ocxpke/ocx/carcasa/img/pieza_07_pisapantalla_der.png

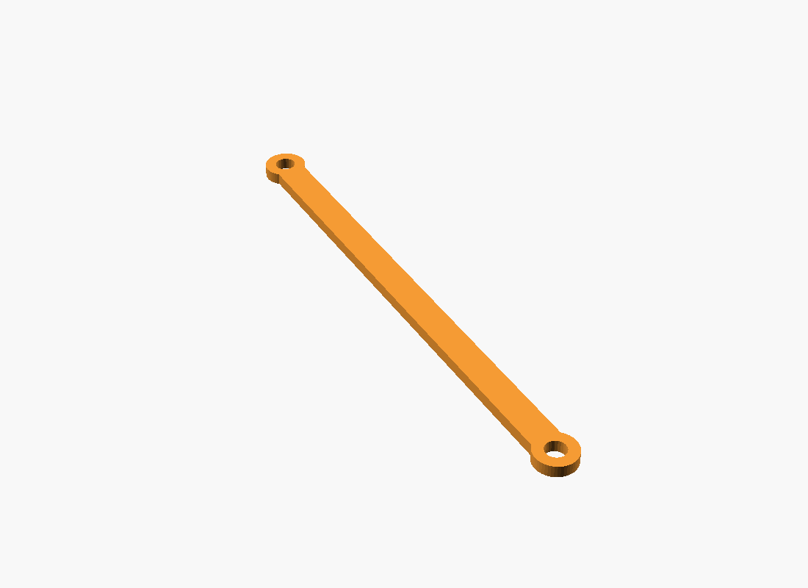
carcasa/img/pieza_07_pisapantalla_der.png
