ocxpke/ocx/carcasa/stl/02_frontal_central.stl

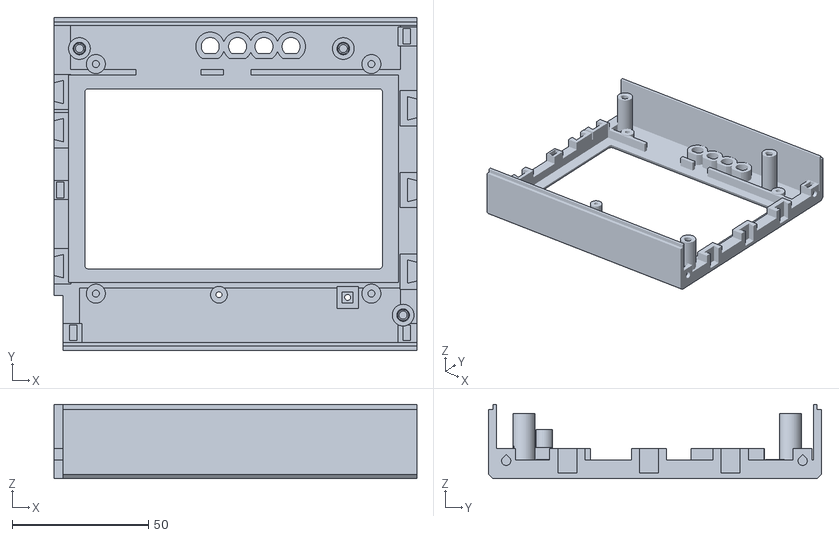
[picture p3: CAD file, 2026-11-05]
carcasa/stl/02_frontal_central.stl
133.4 x 122.4 x 27.2
