ocxpke/ocx/carcasa/stl/capuchones/capuchon_SW9_home.stl

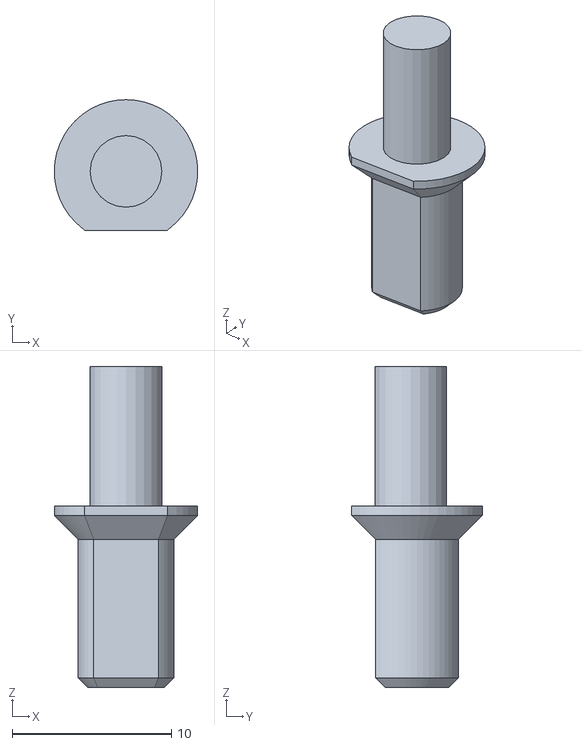
[picture p4: CAD file, 2026-11-05]
carcasa/stl/capuchones/capuchon_SW9_home.stl
9.01 x 8.20 x 20.1
