ocxpke/ocx/carcasa/stl/07_pisapantalla_der.stl

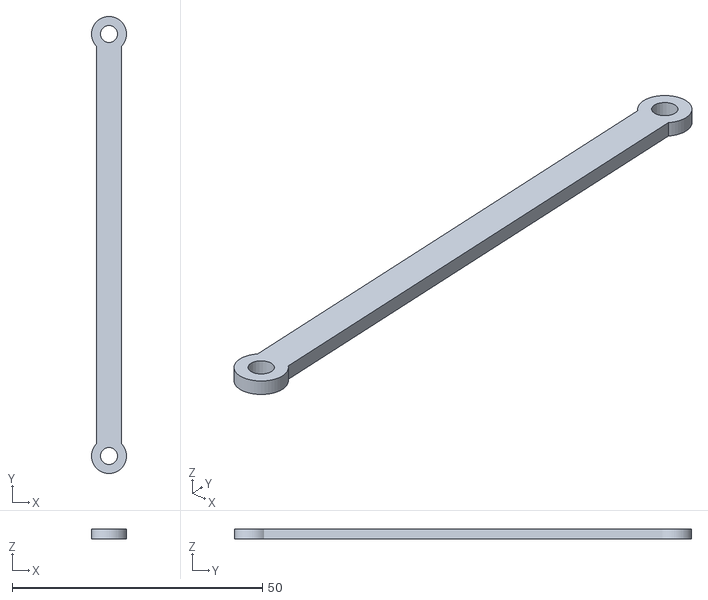
[picture p5: CAD file, 2026-11-05]
carcasa/stl/07_pisapantalla_der.stl
7.00 x 91.4 x 2.00
