ocxpke/ocx/carcasa/stl/00_probeta_ajustes.stl

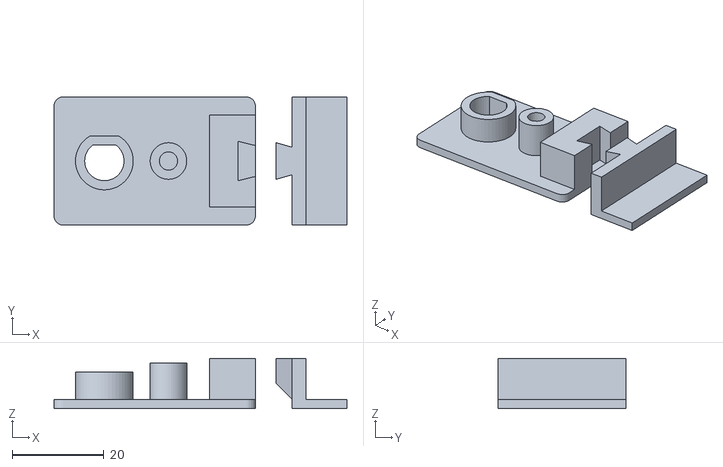
[picture p6: CAD file, 2026-11-05]
carcasa/stl/00_probeta_ajustes.stl
64.0 x 28.0 x 11.0
