ocxpke/ocx/carcasa/stl/capuchones/capuchon_SW13_T_triangulo.stl

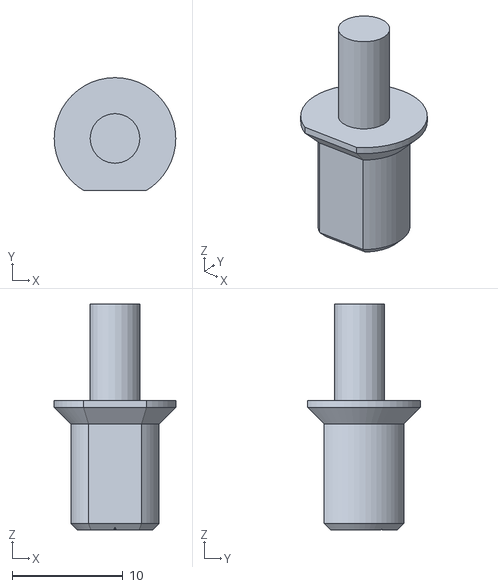
[picture p7: CAD file, 2026-11-05]
carcasa/stl/capuchones/capuchon_SW13_T_triangulo.stl
11.0 x 10.2 x 20.4
