ocxpke/ocx/carcasa/stl/09_bandeja_capuchones.stl

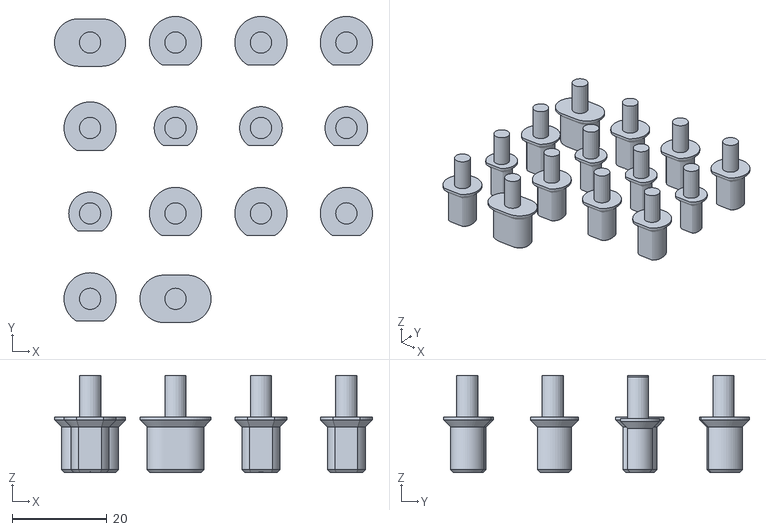
[picture p8: CAD file, 2026-11-05]
carcasa/stl/09_bandeja_capuchones.stl
67.0 x 64.5 x 20.4
