ocxpke/ocx/carcasa/stl/capuchones/capuchon_SW15_gatillo_R.stl

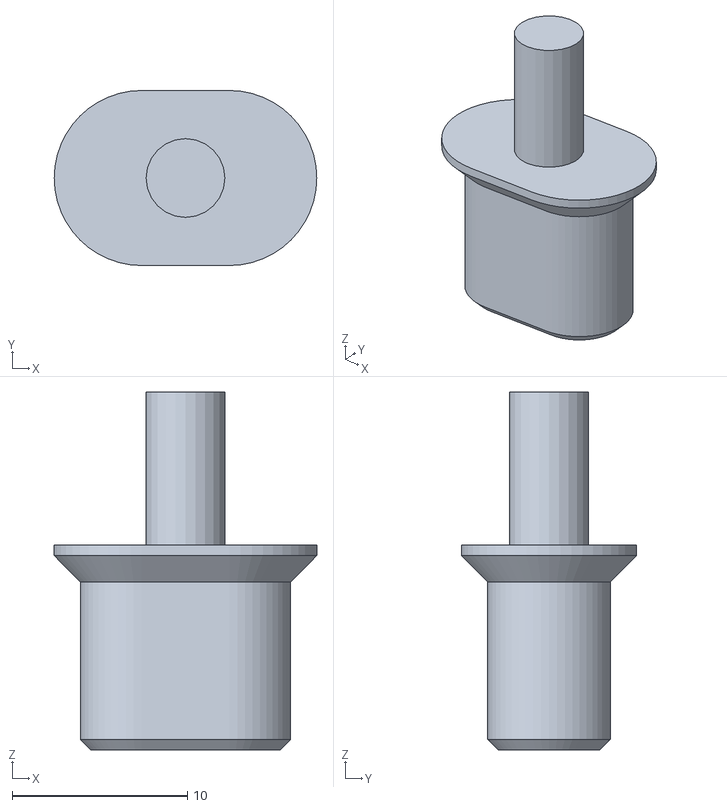
[picture p9: CAD file, 2026-11-05]
carcasa/stl/capuchones/capuchon_SW15_gatillo_R.stl
15.0 x 10.0 x 20.4
