ocxpke/ocx/carcasa/stl/05_trasera_derecha.stl

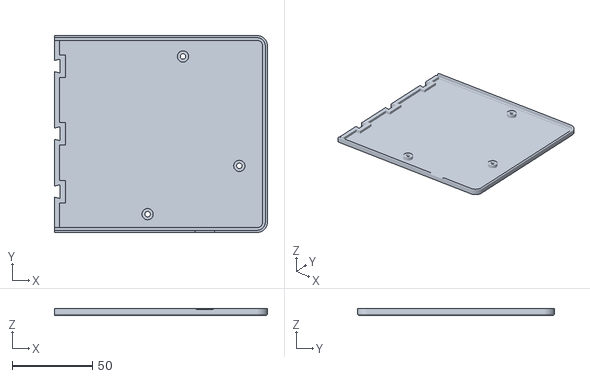
[picture p10: CAD file, 2026-11-05]
carcasa/stl/05_trasera_derecha.stl
132.4 x 122.4 x 4.50
