ocxpke/ocx/carcasa/stl/04_trasera_izquierda.stl

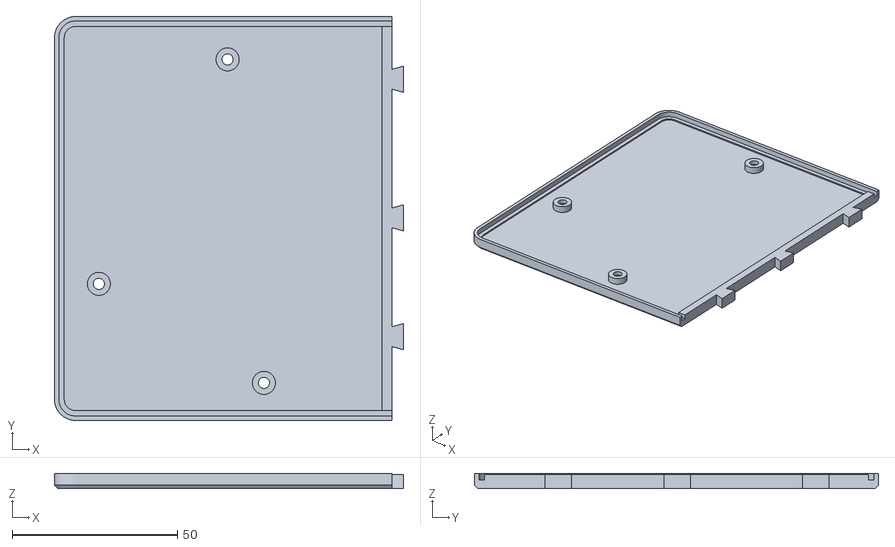
[picture p11: CAD file, 2026-11-05]
carcasa/stl/04_trasera_izquierda.stl
105.8 x 122.4 x 4.50
