ocxpke/ocx/carcasa/stl/03_frontal_derecha.stl

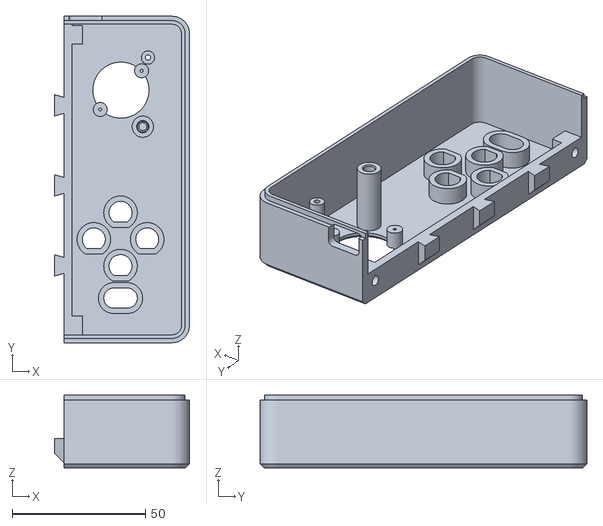
[picture p12: CAD file, 2026-11-05]
carcasa/stl/03_frontal_derecha.stl
50.6 x 122.4 x 27.2
