ocxpke/ocx/carcasa/stl/01_frontal_izquierda.stl

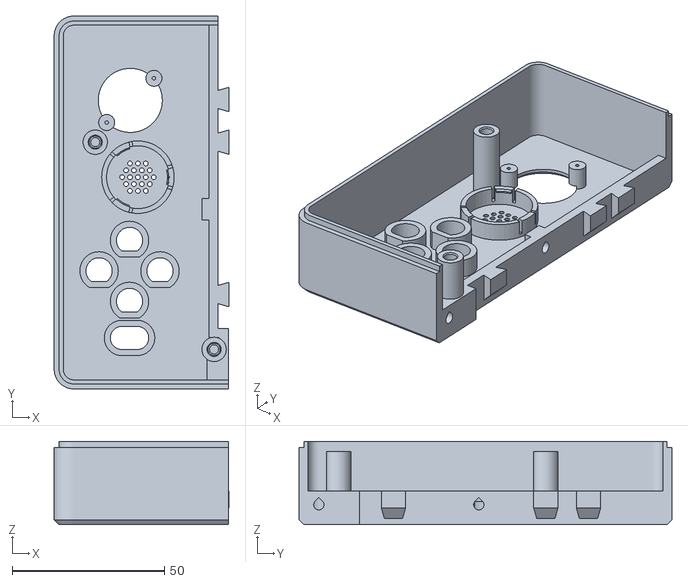
[picture p13: CAD file, 2026-11-05]
carcasa/stl/01_frontal_izquierda.stl
57.3 x 122.4 x 27.2
