ocxpke/ocx/carcasa/stl/capuchones/capuchon_SW7_vol_menos.stl

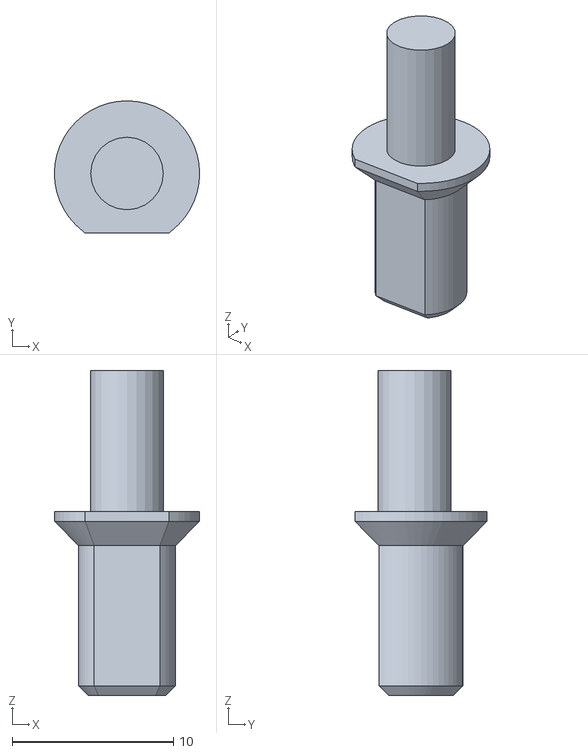
[picture p14: CAD file, 2026-11-05]
carcasa/stl/capuchones/capuchon_SW7_vol_menos.stl
9.01 x 8.20 x 20.1
