ocxpke/ocx/carcasa/stl/08_empujador_boot.stl

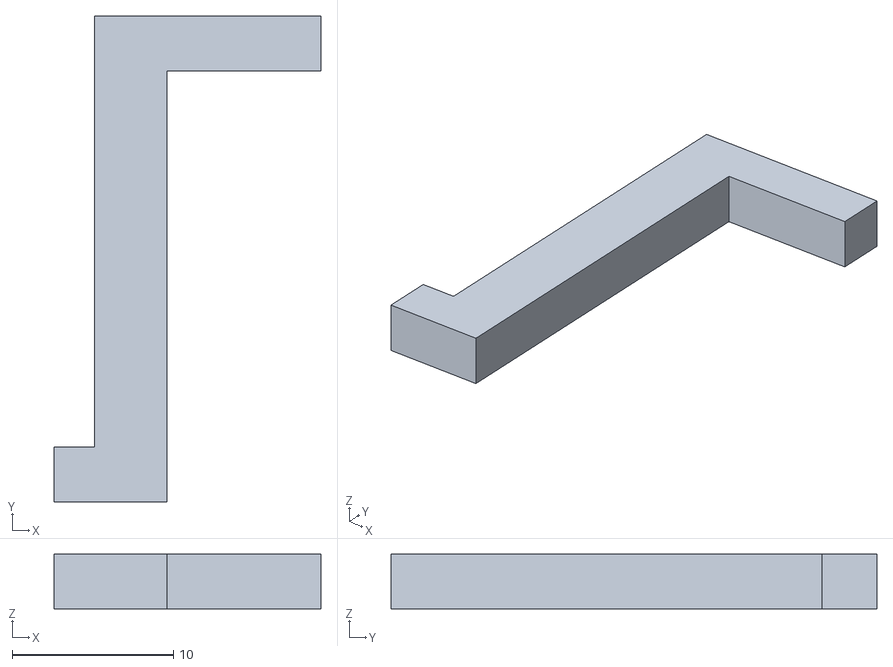
[picture p15: CAD file, 2026-11-05]
carcasa/stl/08_empujador_boot.stl
16.5 x 30.1 x 3.40
