ocxpke/ocx/carcasa/stl/capuchones/capuchon_SW4_izquierda.stl

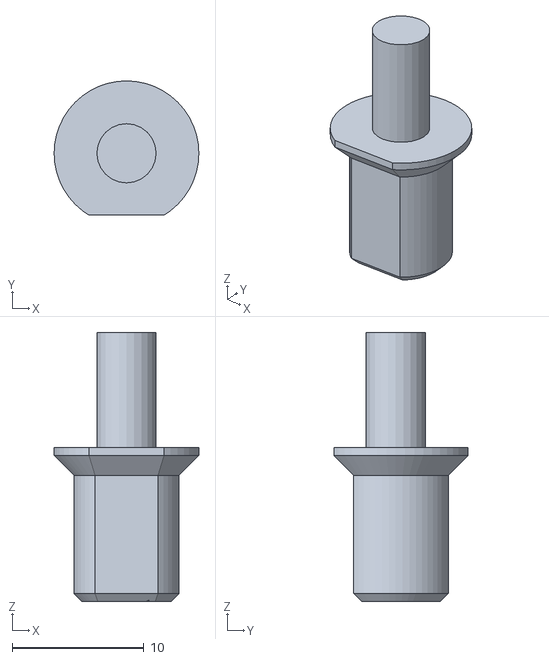
[picture p16: CAD file, 2026-11-05]
carcasa/stl/capuchones/capuchon_SW4_izquierda.stl
11.0 x 10.2 x 20.4
