ocxpke/ocx/carcasa/scad/pcb_data.scad

// GENERADO por carcasa/scripts/extraer_pcb.py a partir de hardware/ocxPrototype.kicad_pcb
// No lo edites a mano: vuelve a ejecutar el script si cambia la placa.
// Coordenadas del .kicad_pcb (mm, eje Y hacia abajo).

PCB_GROSOR = 1.6;
PCB_BBOX = [16, 14.5, 244, 129.9003];   // [xmin, ymin, xmax, ymax]
PCB_ANCHO = 228;
PCB_ALTO = 115.4003;
PCB_RADIO_ESQUINA = 3;
PCB_MUESCA_ANTENA = [136, 14.5, 176, 22.3];   // [xmin, ymin, xmax, ymax]
PCB_CONTORNO = [[16, 17.5], [16, 126.9003], [16.0189, 127.2362], [16.0752, 127.5679], [16.1684, 127.8912], [16.2971, 128.202], [16.4598, 128.4964], [16.6545, 128.7708], [16.8787, 129.0216], [17.1295, 129.2458], [17.4039, 129.4405], [17.6983, 129.6032], [18.0092, 129.732], [18.3324, 129.8251], [18.6641, 129.8815], [19, 129.9003], [241, 129.9003], [241.3359, 129.8815], [241.6676, 129.8251], [241.9908, 129.732], [242.3017, 129.6032], [242.5961, 129.4405], [242.8705, 129.2458], [243.1213, 129.0216], [243.3455, 128.7708], [243.5402, 128.4964], [243.7029, 128.202], [243.8316, 127.8912], [243.9248, 127.5679], [243.9811, 127.2362], [244, 126.9003], [244, 17.5], [243.9836, 17.1865], [243.9344, 16.8763], [243.8532, 16.573], [243.7406, 16.2798], [243.5981, 16], [243.427, 15.7367], [243.2294, 15.4926], [243.0074, 15.2706], [242.7633, 15.073], [242.5, 14.902], [242.2202, 14.7594], [241.927, 14.6469], [241.6237, 14.5656], [241.3135, 14.5165], [241, 14.5], [176, 14.5], [176, 22.3], [136, 22.3], [136, 14.5], [19, 14.5], [18.6641, 14.5189], [18.3324, 14.5752], [18.0092, 14.6684], [17.6983, 14.7971], [17.4039, 14.9598], [17.1295, 15.1545], [16.8787, 15.3787], [16.6545, 15.6295], [16.4598, 15.9039], [16.2971, 16.1983], [16.1684, 16.5092], [16.0752, 16.8324], [16.0189, 17.1641]];
// Agujeros de montaje: [x, y, diámetro]
PCB_AGUJEROS = [[195, 24, 3.2], [230, 92, 3.2], [26, 92, 3.2], [65, 24, 3.2], [173, 122, 3.2], [76, 122, 3.2]];
// Componentes: [ref, valor, huella, x, y, giro, courtyard[x0,y0,x1,y1], fab[x0,y0,x1,y1], centro_pads[x,y], altura, grupo]
PCB_COMPONENTES = [
  ["U6", "LMR51430", "SOT-23-6", 192.58, 107.05, 90, [190.88, 105, 194.28, 109.1], [191.13, 106.25, 194.03, 107.85], [192.58, 107.05], 1.45, "smd"],
  ["R11", "10k", "R_0805_2012Metric_Pad1.20x1.40mm_HandSolder", 129.5, 55.8, 90, [128.55, 53.95, 130.45, 57.65], [128.875, 54.8, 130.125, 56.8], [129.5, 55.8], 1.3, "smd"],
  ["R17", "10k", "R_0805_2012Metric_Pad1.20x1.40mm_HandSolder", 140.9, 34.3, 0, [139.05, 33.35, 142.75, 35.25], [139.9, 33.675, 141.9, 34.925], [140.9, 34.3], 1.3, "smd"],
  ["C36", "100nF", "C_0805_2012Metric_Pad1.18x1.45mm_HandSolder", 130.1, 95.8, 0, [128.22, 94.82, 131.98, 96.78], [129.1, 95.175, 131.1, 96.425], [130.1, 95.8], 1.3, "smd"],
  ["R9", "100 Ohms", "R_0805_2012Metric_Pad1.20x1.40mm_HandSolder", 226.925, 117.9, 180, [225.075, 116.95, 228.775, 118.85], [225.925, 117.275, 227.925, 118.525], [226.925, 117.9], 1.3, "smd"],
  ["U7", "W25Q128JVS", "SOIC-8_5.3x5.3mm_P1.27mm", 135.5, 56.5, 0, [130.85, 53.6, 140.15, 59.4], [132.85, 53.85, 138.15, 59.15], [135.5, 56.5], 2.2, "smd"],
  ["C18", "220pF C0G", "C_0805_2012Metric_Pad1.18x1.45mm_HandSolder", 56.4888, 105.719, 90, [55.509, 103.839, 57.469, 107.599], [55.864, 104.719, 57.114, 106.719], [56.489, 105.719], 1.3, "smd"],
  ["U2", "USBLC6-2SC6", "SOT-23-6", 207.98, 113.05, -90, [206.28, 111, 209.68, 115.1], [206.53, 112.25, 209.43, 113.85], [207.98, 113.05], 1.45, "smd"],
  ["C20", "10uF 25V", "C_0805_2012Metric_Pad1.18x1.45mm_HandSolder", 82.1375, 83.7, 180, [80.258, 82.72, 84.017, 84.68], [81.138, 83.075, 83.138, 84.325], [82.137, 83.7], 1.3, "smd"],
  ["FB2", "100 Ohms @ 100 MHz 0.8A", "L_0805_2012Metric_Pad1.05x1.20mm_HandSolder", 53.1888, 106.7565, 0, [51.259, 105.906, 55.119, 107.606], [52.189, 106.306, 54.189, 107.206], [53.189, 106.756], 1.3, "smd"],
  ["C21", "2.2uF 50V", "C_1206_3216Metric_Pad1.33x1.80mm_HandSolder", 93.3375, 82.6, 180, [90.858, 81.45, 95.818, 83.75], [91.738, 81.8, 94.938, 83.4], [93.338, 82.6], 1.8, "smd"],
  ["R10", "47k", "R_0805_2012Metric_Pad1.20x1.40mm_HandSolder", 46.8888, 106.0565, 0, [45.039, 105.106, 48.739, 107.006], [45.889, 105.431, 47.889, 106.681], [46.889, 106.056], 1.3, "smd"],
  ["SW14", "SW_Reset", "SW_PUSH_6mm", 130.55, 33.75, 180, [122.55, 27.75, 132.05, 35.25], [124.3, 28.5, 130.3, 34.5], [127.3, 31.5], 5, "pulsador"],
  ["J7", "JoystickRight", "TE_0-1734839-5_1x05-1MP_P0.5mm_Horizontal", 221.8, 80, 0, [217.33, 77.59, 226.27, 84.25], [217.835, 79.35, 225.765, 83.75], [221.8, 78.65], 2, "conector"],
  ["SW10", "BTN_X", "SW_PUSH_6mm", 224.9, 62, 180, [216.9, 56, 226.4, 63.5], [218.65, 56.75, 224.65, 62.75], [221.65, 59.75], 5, "pulsador"],
  ["TP3", "TestPoint", "TestPoint_Pad_D1.5mm", 184.5, 124.2, 180, [183.25, 122.95, 185.75, 125.45], undef, [184.5, 124.2], 0.2, "smd"],
  ["C15", "10uF 25V", "C_0805_2012Metric_Pad1.18x1.45mm_HandSolder", 197.18, 109.95, 0, [195.3, 108.97, 199.06, 110.93], [196.18, 109.325, 198.18, 110.575], [197.18, 109.95], 1.3, "smd"],
  ["C3", "1uF", "C_0402_1005Metric", 127.4, 67.3, 90, [126.94, 66.39, 127.86, 68.21], [127.15, 66.8, 127.65, 67.8], [127.4, 67.3], 0.7, "smd"],
  ["C2", "33pF C0G", "C_0402_1005Metric", 121.5975, 48.555, 0, [120.688, 48.095, 122.507, 49.015], [121.097, 48.305, 122.097, 48.805], [121.597, 48.555], 0.7, "smd"],
  ["C5", "100nF", "C_0402_1005Metric", 115.2, 52.58, -90, [114.74, 51.67, 115.66, 53.49], [114.95, 52.08, 115.45, 53.08], [115.2, 52.58], 0.7, "smd"],
  ["J6", "JoystickLeft", "TE_0-1734839-5_1x05-1MP_P0.5mm_Horizontal", 37.5, 80, 0, [33.03, 77.59, 41.97, 84.25], [33.535, 79.35, 41.465, 83.75], [37.5, 78.65], 2, "conector"],
  ["C28", "10uF 25V", "C_0805_2012Metric_Pad1.18x1.45mm_HandSolder", 117.7, 52.7, -90, [116.72, 50.82, 118.68, 54.58], [117.075, 51.7, 118.325, 53.7], [117.7, 52.7], 1.3, "smd"],
  ["SW5", "BTN_A_DW", "SW_PUSH_6mm", 40.5, 62, 180, [32.5, 56, 42, 63.5], [34.25, 56.75, 40.25, 62.75], [37.25, 59.75], 5, "pulsador"],
  ["R1", "1k", "R_0805_2012Metric_Pad1.20x1.40mm_HandSolder", 111, 58.3, 0, [109.15, 57.35, 112.85, 59.25], [110, 57.675, 112, 58.925], [111, 58.3], 1.3, "smd"],
  ["SW11", "BTN_O", "SW_PUSH_6mm", 234.9, 52, 180, [226.9, 46, 236.4, 53.5], [228.65, 46.75, 234.65, 52.75], [231.65, 49.75], 5, "pulsador"],
  ["L2", "22uH", "L_Sunlord_SWPA4030S", 85.5375, 87.4, 0, [83.237, 85.15, 87.837, 89.65], [83.537, 85.4, 87.537, 89.4], [85.537, 87.4], 3, "smd"],
  ["R14", "22 Ohms", "R_0805_2012Metric_Pad1.20x1.40mm_HandSolder", 171.8, 72.4, 180, [169.95, 71.45, 173.65, 73.35], [170.8, 71.775, 172.8, 73.025], [171.8, 72.4], 1.3, "smd"],
  ["C33", "100nF", "C_0805_2012Metric_Pad1.18x1.45mm_HandSolder", 170.6, 35.3375, -90, [169.62, 33.457, 171.58, 37.218], [169.975, 34.337, 171.225, 36.337], [170.6, 35.337], 1.3, "smd"],
  ["L3", "2.2uH", "L_Coilcraft_XxL4020", 192.68, 113.45, -90, [190.42, 111.19, 194.94, 115.71], [190.68, 111.45, 194.68, 115.45], [192.68, 113.45], 2.1, "smd"],
  ["SW9", "BTN_HOME", "SW_PUSH_6mm", 150.55, 120.5, 0, [149.05, 119, 158.55, 126.5], [150.8, 119.75, 156.8, 125.75], [153.8, 122.75], 5, "pulsador"],
  ["C22", "100nF", "C_0805_2012Metric_Pad1.18x1.45mm_HandSolder", 189.765, 107.05, -90, [188.785, 105.17, 190.745, 108.93], [189.14, 106.05, 190.39, 108.05], [189.765, 107.05], 1.3, "smd"],
  ["R21", "22k 1%", "R_0805_2012Metric_Pad1.20x1.40mm_HandSolder", 196.165, 105.95, 0, [194.315, 105, 198.015, 106.9], [195.165, 105.325, 197.165, 106.575], [196.165, 105.95], 1.3, "smd"],
  ["R15", "22 Ohms", "R_0805_2012Metric_Pad1.20x1.40mm_HandSolder", 171.8, 69.9, 180, [169.95, 68.95, 173.65, 70.85], [170.8, 69.275, 172.8, 70.525], [171.8, 69.9], 1.3, "smd"],
  ["C17", "100nF", "C_0402_1005Metric", 139.2, 53.1, 180, [138.29, 52.64, 140.11, 53.56], [138.7, 52.85, 139.7, 53.35], [139.2, 53.1], 0.7, "smd"],
  ["J3", "ESP32_S3_DEVKIT_RIGHT", "PinSocket_1x22_P2.54mm_Vertical", 167.46, 77.48, 180, [165.69, 22.37, 169.23, 79.25], [166.19, 22.87, 168.73, 78.75], [167.46, 50.81], 8.5, "zocalo"],
  ["J1", "J_LCD", "Omron_XF2M-4015-1A_1x40-1MP_P0.5mm_Horizontal", 108.74, 103.2, 0, [95.36, 100.32, 122.12, 107], [96.99, 101.525, 120.49, 106.425], [108.74, 101.15], 2, "conector"],
  ["J4", "CTP", "TE_84953-6_1x06-1MP_P1.0mm_Horizontal", 134, 101.15, 0, [126.54, 97.85, 141.46, 108.15], [127.04, 100.35, 140.96, 107.65], [134, 99.35], 2.6, "conector"],
  ["C14", "100nF", "C_0805_2012Metric_Pad1.18x1.45mm_HandSolder", 152.78, 87.6, 0, [150.9, 86.62, 154.66, 88.58], [151.78, 86.975, 153.78, 88.225], [152.78, 87.6], 1.3, "smd"],
  ["C9", "22uF 25V", "C_0805_2012Metric_Pad1.18x1.45mm_HandSolder", 188.2175, 114.55, 180, [186.338, 113.57, 190.097, 115.53], [187.218, 113.925, 189.218, 115.175], [188.218, 114.55], 1.3, "smd"],
  ["R5", "10k", "R_0805_2012Metric_Pad1.20x1.40mm_HandSolder", 151.3, 102.7, 90, [150.35, 100.85, 152.25, 104.55], [150.675, 101.7, 151.925, 103.7], [151.3, 102.7], 1.3, "smd"],
  ["C26", "100nF", "C_0402_1005Metric", 129.4, 68, 90, [128.94, 67.09, 129.86, 68.91], [129.15, 67.5, 129.65, 68.5], [129.4, 68], 0.7, "smd"],
  ["TP11", "TestPoint", "TestPoint_Pad_D1.5mm", 89.2375, 92.1, 0, [87.987, 90.85, 90.487, 93.35], undef, [89.237, 92.1], 0.2, "smd"],
  ["SW8", "BTN_VOL_+", "SW_PUSH_6mm", 140.6, 120.5, 0, [139.1, 119, 148.6, 126.5], [140.85, 119.75, 146.85, 125.75], [143.85, 122.75], 5, "pulsador"],
  ["C34", "100nF", "C_0805_2012Metric_Pad1.18x1.45mm_HandSolder", 96.4, 94.3, 180, [94.52, 93.32, 98.28, 95.28], [95.4, 93.675, 97.4, 94.925], [96.4, 94.3], 1.3, "smd"],
  ["J5", "Audio_+_-", "JST_PH_B2B-PH-K_1x02_P2.00mm_Vertical", 65.6388, 111.4565, 90, [63.439, 107.006, 68.939, 113.906], [63.529, 107.506, 68.439, 113.816], [65.639, 110.456], 6, "conector"],
  ["SW7", "BTN_VOL_-", "SW_PUSH_6mm", 130.9, 120.5, 0, [129.4, 119, 138.9, 126.5], [131.15, 119.75, 137.15, 125.75], [134.15, 122.75], 5, "pulsador"],
  ["C24", "100nF", "C_0402_1005Metric", 119.3, 71.6, 45, [118.331, 70.631, 120.269, 72.569], [118.77, 71.07, 119.83, 72.13], [119.3, 71.6], 0.7, "smd"],
  ["C31", "100nF", "C_0805_2012Metric_Pad1.18x1.45mm_HandSolder", 139.3625, 39.7, 180, [137.483, 38.72, 141.243, 40.68], [138.363, 39.075, 140.363, 40.325], [139.363, 39.7], 1.3, "smd"],
  ["C19", "220pF C0G", "C_0805_2012Metric_Pad1.18x1.45mm_HandSolder", 56.2888, 114.894, 90, [55.309, 113.014, 57.269, 116.774], [55.664, 113.894, 56.914, 115.894], [56.289, 114.893], 1.3, "smd"],
  ["TP1", "TestPoint", "TestPoint_Pad_D1.5mm", 193, 124.2, 180, [191.75, 122.95, 194.25, 125.45], undef, [193, 124.2], 0.2, "smd"],
  ["C7", "10uF 25V", "C_0805_2012Metric_Pad1.18x1.45mm_HandSolder", 56.0888, 110.419, -90, [55.109, 108.539, 57.069, 112.299], [55.464, 109.419, 56.714, 111.419], [56.089, 110.418], 1.3, "smd"],
  ["C25", "100nF", "C_0402_1005Metric", 126.92, 58.7, 180, [126.01, 58.24, 127.83, 59.16], [126.42, 58.45, 127.42, 58.95], [126.92, 58.7], 0.7, "smd"],
  ["R28", "0.1 Ohms 1%", "R_1206_3216Metric_Pad1.30x1.75mm_HandSolder", 214.9, 107.9, 90, [213.77, 105.45, 216.03, 110.35], [214.1, 106.3, 215.7, 109.5], [214.9, 107.9], 1.8, "smd"],
  ["C10", "4.7nF", "C_0805_2012Metric_Pad1.18x1.45mm_HandSolder", 32.6888, 109.6565, -90, [31.709, 107.776, 33.669, 111.536], [32.064, 108.656, 33.314, 110.656], [32.689, 109.656], 1.3, "smd"],
  ["TP6", "TestPoint", "TestPoint_Pad_D1.0mm", 135.6, 77.1, 0, [134.6, 76.1, 136.6, 78.1], undef, [135.6, 77.1], 0.2, "smd"],
  ["C13", "0.22uF", "C_0805_2012Metric_Pad1.18x1.45mm_HandSolder", 42.7888, 113.8565, 90, [41.809, 111.976, 43.769, 115.736], [42.164, 112.856, 43.414, 114.856], [42.789, 113.857], 1.3, "smd"],
  ["D3", "SS210", "D_SMA_Handsoldering", 93.8375, 85.8, 180, [89.338, 84.05, 98.338, 87.55], [91.538, 84.3, 96.138, 87.3], [93.838, 85.8], 2.4, "smd"],
  ["C4", "100nF", "C_0402_1005Metric", 116.2, 52.58, -90, [115.74, 51.67, 116.66, 53.49], [115.95, 52.08, 116.45, 53.08], [116.2, 52.58], 0.7, "smd"],
  ["FB1", "100 Ohms @ 100 MHz 0.8A", "L_0805_2012Metric_Pad1.05x1.20mm_HandSolder", 53.1888, 113.8565, 0, [51.259, 113.006, 55.119, 114.706], [52.189, 113.406, 54.189, 114.306], [53.189, 113.856], 1.3, "smd"],
  ["SW1", "BTN_T_L", "SW_PUSH_6mm", 40.5, 30, 180, [32.5, 24, 42, 31.5], [34.25, 24.75, 40.25, 30.75], [37.25, 27.75], 5, "pulsador"],
  ["C16", "22uF 25V", "C_0805_2012Metric_Pad1.18x1.45mm_HandSolder", 188.18, 112.15, 180, [186.3, 111.17, 190.06, 113.13], [187.18, 111.525, 189.18, 112.775], [188.18, 112.15], 1.3, "smd"],
  ["C6", "100nF", "C_0402_1005Metric", 127.2, 62.9, 180, [126.29, 62.44, 128.11, 63.36], [126.7, 62.65, 127.7, 63.15], [127.2, 62.9], 0.7, "smd"],
  ["R19", "10k", "R_0805_2012Metric_Pad1.20x1.40mm_HandSolder", 140.8, 63.8, 0, [138.95, 62.85, 142.65, 64.75], [139.8, 63.175, 141.8, 64.425], [140.8, 63.8], 1.3, "smd"],
  ["C1", "33pF C0G", "C_0402_1005Metric", 124.17, 54.28, 90, [123.71, 53.37, 124.63, 55.19], [123.92, 53.78, 124.42, 54.78], [124.17, 54.28], 0.7, "smd"],
  ["C23", "100nF", "C_0402_1005Metric", 126.3, 67.3, 90, [125.84, 66.39, 126.76, 68.21], [126.05, 66.8, 126.55, 67.8], [126.3, 67.3], 0.7, "smd"],
  ["C37", "100nF", "C_0805_2012Metric_Pad1.18x1.45mm_HandSolder", 209.08, 117.15, 0, [207.2, 116.17, 210.96, 118.13], [208.08, 116.525, 210.08, 117.775], [209.081, 117.15], 1.3, "smd"],
  ["TP8", "TestPoint", "TestPoint_Pad_D1.0mm", 133.9, 72.8, 0, [132.9, 71.8, 134.9, 73.8], undef, [133.9, 72.8], 0.2, "smd"],
  ["R25", "10k", "R_0805_2012Metric_Pad1.20x1.40mm_HandSolder", 111, 54.3, 0, [109.15, 53.35, 112.85, 55.25], [110, 53.675, 112, 54.925], [111, 54.3], 1.3, "smd"],
  ["R23", "100k 1%", "R_0805_2012Metric_Pad1.20x1.40mm_HandSolder", 83.2375, 80.5, 180, [81.388, 79.55, 85.087, 81.45], [82.237, 79.875, 84.237, 81.125], [83.237, 80.5], 1.3, "smd"],
  ["R16", "10k", "R_0805_2012Metric_Pad1.20x1.40mm_HandSolder", 141.6, 53.8, 90, [140.65, 51.95, 142.55, 55.65], [140.975, 52.8, 142.225, 54.8], [141.6, 53.8], 1.3, "smd"],
  ["R18", "10k", "R_0805_2012Metric_Pad1.20x1.40mm_HandSolder", 140.8, 32, 0, [138.95, 31.05, 142.65, 32.95], [139.8, 31.375, 141.8, 32.625], [140.8, 32], 1.3, "smd"],
  ["FB3", "600 Ohms @ 100 MHz 0.5A", "L_0805_2012Metric_Pad1.05x1.20mm_HandSolder", 96.4375, 89.4, 0, [94.507, 88.55, 98.368, 90.25], [95.438, 88.95, 97.438, 89.85], [96.438, 89.4], 1.3, "smd"],
  ["SW6", "BTN_SLCT", "SW_PUSH_6mm", 120.85, 120.5, 0, [119.35, 119, 128.85, 126.5], [121.1, 119.75, 127.1, 125.75], [124.1, 122.75], 5, "pulsador"],
  ["SW13", "BTN_T", "SW_PUSH_6mm", 224.9, 42, 180, [216.9, 36, 226.4, 43.5], [218.65, 36.75, 224.65, 42.75], [221.65, 39.75], 5, "pulsador"],
  ["SW16", "SW_Boot", "SW_PUSH_6mm", 171.35, 54.95, 0, [169.85, 53.45, 179.35, 60.95], [171.6, 54.2, 177.6, 60.2], [174.6, 57.2], 5, "pulsador"],
  ["R12", "5.1k", "R_0805_2012Metric_Pad1.20x1.40mm_HandSolder", 200.6, 120.2, 0, [198.75, 119.25, 202.45, 121.15], [199.6, 119.575, 201.6, 120.825], [200.6, 120.2], 1.3, "smd"],
  ["Y1", "12MHz 20 pF", "Crystal_SMD_5032-4Pin_5.0x3.2mm", 121.57, 52.18, 90, [119.47, 49.18, 123.67, 55.18], [119.97, 49.68, 123.17, 54.68], [121.57, 52.18], 1.3, "smd"],
  ["R20", "100k 1%", "R_0805_2012Metric_Pad1.20x1.40mm_HandSolder", 194.965, 103.95, 0, [193.115, 103, 196.815, 104.9], [193.965, 103.325, 195.965, 104.575], [194.965, 103.95], 1.3, "smd"],
  ["TP2", "TestPoint", "TestPoint_Keystone_5000-5004_Miniature", 188.9, 124.2, 180, [187.25, 122.55, 190.55, 125.85], [187.65, 122.95, 190.15, 125.45], [188.9, 124.2], 5, "smd"],
  ["C11", "1uF", "C_0805_2012Metric_Pad1.18x1.45mm_HandSolder", 53.8888, 110.419, -90, [52.909, 108.539, 54.869, 112.299], [53.264, 109.419, 54.514, 111.419], [53.889, 110.418], 1.3, "smd"],
  ["TP7", "TestPoint", "TestPoint_Pad_D1.0mm", 139, 77.1, 0, [138, 76.1, 140, 78.1], undef, [139, 77.1], 0.2, "smd"],
  ["R22", "3.3 Ohms 1%", "R_0805_2012Metric_Pad1.20x1.40mm_HandSolder", 89.3375, 80.5, 0, [87.488, 79.55, 91.188, 81.45], [88.338, 79.875, 90.338, 81.125], [89.338, 80.5], 1.3, "smd"],
  ["C38", "100nF", "C_0805_2012Metric_Pad1.18x1.45mm_HandSolder", 108.9, 61.9, -90, [107.92, 60.02, 109.88, 63.78], [108.275, 60.9, 109.525, 62.9], [108.9, 61.9], 1.3, "smd"],
  ["R8", "10k", "R_0805_2012Metric_Pad1.20x1.40mm_HandSolder", 133, 52.6, 180, [131.15, 51.65, 134.85, 53.55], [132, 51.975, 134, 53.225], [133, 52.6], 1.3, "smd"],
  ["U5", "MCP23017x-x-SO", "SOIC-28W_7.5x17.9mm_P1.27mm", 154.695, 94.75, -90, [145.495, 88.82, 163.895, 100.68], [145.745, 91, 163.645, 98.5], [154.695, 94.75], 2.65, "smd"],
  ["TP9", "TestPoint", "TestPoint_Pad_D1.0mm", 137.5, 72.7, 0, [136.5, 71.7, 138.5, 73.7], undef, [137.5, 72.7], 0.2, "smd"],
  ["J10", "USB_C_Receptacle_USB2.0_16P", "USB_C_Receptacle_HRO_TYPE-C-31-M-12", 208.48, 126.25, 0, [203.16, 120.98, 213.8, 130.4], [204.01, 122.6, 212.95, 129.9], [208.48, 122.205], 3.3, "conector"],
  ["U8", "DIO5661ST6", "SOT-23-6", 86.342, 83.152, 180, [84.292, 81.452, 88.392, 84.852], [85.542, 81.702, 87.142, 84.602], [86.343, 83.152], 1.45, "smd"],
  ["R6", "4.7k", "R_0805_2012Metric_Pad1.20x1.40mm_HandSolder", 149.88, 86.7, -90, [148.93, 84.85, 150.83, 88.55], [149.255, 85.7, 150.505, 87.7], [149.88, 86.7], 1.3, "smd"],
  ["C27", "10uF 10V", "C_0603_1608Metric", 116.4, 55.5, 0, [114.92, 54.77, 117.88, 56.23], [115.6, 55.1, 117.2, 55.9], [116.4, 55.5], 1, "smd"],
  ["SW2", "BTN_A_UP", "SW_PUSH_6mm", 40.5, 42, 180, [32.5, 36, 42, 43.5], [34.25, 36.75, 40.25, 42.75], [37.25, 39.75], 5, "pulsador"],
  ["R27", "10k", "R_0805_2012Metric_Pad1.20x1.40mm_HandSolder", 170.3, 63.8, 90, [169.35, 61.95, 171.25, 65.65], [169.675, 62.8, 170.925, 64.8], [170.3, 63.8], 1.3, "smd"],
  ["C30", "100nF", "C_0805_2012Metric_Pad1.18x1.45mm_HandSolder", 139.3, 36.3, 180, [137.42, 35.32, 141.18, 37.28], [138.3, 35.675, 140.3, 36.925], [139.3, 36.3], 1.3, "smd"],
  ["C29", "1nF", "C_0805_2012Metric_Pad1.18x1.45mm_HandSolder", 38.6888, 109.6565, 90, [37.709, 107.776, 39.669, 111.536], [38.064, 108.656, 39.314, 110.656], [38.689, 109.656], 1.3, "smd"],
  ["SW3", "BTN_A_R", "SW_PUSH_6mm", 50.5, 52, 180, [42.5, 46, 52, 53.5], [44.25, 46.75, 50.25, 52.75], [47.25, 49.75], 5, "pulsador"],
  ["C40", "100 uF", "CP_Elec_6.3x5.8", 223.4, 106.3, 0, [218.7, 102.75, 228.1, 109.85], [220.1, 103, 226.7, 109.6], [223.4, 106.3], 6, "smd"],
  ["C39", "100nF", "C_0805_2012Metric_Pad1.18x1.45mm_HandSolder", 114.9, 94, 0, [113.02, 93.02, 116.78, 94.98], [113.9, 93.375, 115.9, 94.625], [114.9, 94], 1.3, "smd"],
  ["C32", "100nF", "C_0805_2012Metric_Pad1.18x1.45mm_HandSolder", 170.6, 30.7, 90, [169.62, 28.82, 171.58, 32.58], [169.975, 29.7, 171.225, 31.7], [170.6, 30.7], 1.3, "smd"],
  ["D1", "P6SMB6.8CA", "D_SMB_Handsoldering", 203.4, 113, 90, [201.15, 108.3, 205.65, 117.7], [201.4, 110.7, 205.4, 115.3], [203.4, 113], 2.45, "smd"],
  ["R7", "4.7k", "R_0805_2012Metric_Pad1.20x1.40mm_HandSolder", 146.68, 86.8, 90, [145.73, 84.95, 147.63, 88.65], [146.055, 85.8, 147.305, 87.8], [146.68, 86.8], 1.3, "smd"],
  ["U4", "PAM8302AAD", "SOIC-8_3.9x4.9mm_P1.27mm", 48.2927, 110.365, 0, [44.593, 107.665, 51.993, 113.065], [46.343, 107.915, 50.243, 112.815], [48.293, 110.365], 1.75, "smd"],
  ["C8", "100nF", "C_0805_2012Metric_Pad1.18x1.45mm_HandSolder", 192.68, 110.15, 180, [190.8, 109.17, 194.56, 111.13], [191.68, 109.525, 193.68, 110.775], [192.68, 110.15], 1.3, "smd"],
  ["R4", "3.3k", "R_0805_2012Metric_Pad1.20x1.40mm_HandSolder", 29.6927, 110.565, 0, [27.843, 109.615, 31.543, 111.515], [28.693, 109.94, 30.693, 111.19], [29.693, 110.565], 1.3, "smd"],
  ["TP4", "TestPoint", "TestPoint_Pad_D1.5mm", 141.2, 72.7, 0, [139.95, 71.45, 142.45, 73.95], undef, [141.2, 72.7], 0.2, "smd"],
  ["TP5", "TestPoint", "TestPoint_Pad_D1.0mm", 132.3, 77.1, 0, [131.3, 76.1, 133.3, 78.1], undef, [132.3, 77.1], 0.2, "smd"],
  ["TP10", "TestPoint", "TestPoint_Pad_D1.0mm", 130.9, 72.8, 0, [129.9, 71.8, 131.9, 73.8], undef, [130.9, 72.8], 0.2, "smd"],
  ["SW4", "BTN_A_L", "SW_PUSH_6mm", 30.5, 52, 180, [22.5, 46, 32, 53.5], [24.25, 46.75, 30.25, 52.75], [27.25, 49.75], 5, "pulsador"],
  ["R3", "1k", "R_0805_2012Metric_Pad1.20x1.40mm_HandSolder", 35.6927, 110.565, 0, [33.843, 109.615, 37.543, 111.515], [34.693, 109.94, 36.693, 111.19], [35.693, 110.565], 1.3, "smd"],
  ["U1", "BT817Q", "VQFN-64-1EP_9x9mm_P0.5mm_EP5.4x5.4mm_ThermalVias", 120.3, 63.3, 180, [115.2, 58.2, 125.4, 68.4], [115.8, 58.8, 124.8, 67.8], [120.3, 63.3], 1, "smd"],
  ["R24", "33 Ohms", "R_0402_1005Metric", 111.09, 62.6, 0, [110.16, 62.13, 112.02, 63.07], [110.565, 62.33, 111.615, 62.87], [111.09, 62.6], 0.7, "smd"],
  ["C35", "10uF 25V", "C_0805_2012Metric_Pad1.18x1.45mm_HandSolder", 96.4, 91.5, 180, [94.52, 90.52, 98.28, 92.48], [95.4, 90.875, 97.4, 92.125], [96.4, 91.5], 1.3, "smd"],
  ["TP12", "TestPoint", "TestPoint_Pad_D1.5mm", 89.3, 95.4, 0, [88.05, 94.15, 90.55, 96.65], undef, [89.3, 95.4], 0.2, "smd"],
  ["SW15", "BTN_T_R", "SW_PUSH_6mm", 224.9, 30, 180, [216.9, 24, 226.4, 31.5], [218.65, 24.75, 224.65, 30.75], [221.65, 27.75], 5, "pulsador"],
  ["D2", "GREEN", "LED_0805_2012Metric_Pad1.15x1.40mm_HandSolder", 231.925, 117.9, 0, [230.075, 116.95, 233.775, 118.85], [230.925, 117.3, 232.925, 118.5], [231.925, 117.9], 1.3, "smd"],
  ["J2", "ESP32_S3_DEVKIT_LEFT", "PinSocket_1x22_P2.54mm_Vertical", 144.6, 24.14, 0, [142.83, 22.37, 146.37, 79.25], [143.33, 22.87, 145.87, 78.75], [144.6, 50.81], 8.5, "zocalo"],
  ["SW12", "BTN_C", "SW_PUSH_6mm", 214.9, 52, 180, [206.9, 46, 216.4, 53.5], [208.65, 46.75, 214.65, 52.75], [211.65, 49.75], 5, "pulsador"],
  ["C12", "0.22uF", "C_0805_2012Metric_Pad1.18x1.45mm_HandSolder", 41.8888, 110.7565, 0, [40.009, 109.776, 43.769, 111.736], [40.889, 110.131, 42.889, 111.381], [41.889, 110.756], 1.3, "smd"],
  ["R2", "1k", "R_0805_2012Metric_Pad1.20x1.40mm_HandSolder", 111, 56.3, 0, [109.15, 55.35, 112.85, 57.25], [110, 55.675, 112, 56.925], [111, 56.3], 1.3, "smd"],
  ["R26", "10k", "R_0805_2012Metric_Pad1.20x1.40mm_HandSolder", 141.5, 48.5, 90, [140.55, 46.65, 142.45, 50.35], [140.875, 47.5, 142.125, 49.5], [141.5, 48.5], 1.3, "smd"],
  ["R13", "5.1k", "R_0805_2012Metric_Pad1.20x1.40mm_HandSolder", 214.88, 119.85, 180, [213.03, 118.9, 216.73, 120.8], [213.88, 119.225, 215.88, 120.475], [214.88, 119.85], 1.3, "smd"],
];
// Patillas pasantes que asoman por debajo: [ref, x, y, radio del pad]
PCB_THT = [["SW14", 130.55, 33.75, 1], ["SW14", 124.05, 33.75, 1], ["SW14", 130.55, 29.25, 1], ["SW14", 124.05, 29.25, 1], ["SW10", 224.9, 62, 1], ["SW10", 218.4, 62, 1], ["SW10", 224.9, 57.5, 1], ["SW10", 218.4, 57.5, 1], ["SW5", 40.5, 62, 1], ["SW5", 34, 62, 1], ["SW5", 40.5, 57.5, 1], ["SW5", 34, 57.5, 1], ["SW11", 234.9, 52, 1], ["SW11", 228.4, 52, 1], ["SW11", 234.9, 47.5, 1], ["SW11", 228.4, 47.5, 1], ["SW9", 150.55, 120.5, 1], ["SW9", 157.05, 120.5, 1], ["SW9", 150.55, 125, 1], ["SW9", 157.05, 125, 1], ["J3", 167.46, 77.48, 0.85], ["J3", 167.46, 74.94, 0.85], ["J3", 167.46, 72.4, 0.85], ["J3", 167.46, 69.86, 0.85], ["J3", 167.46, 67.32, 0.85], ["J3", 167.46, 64.78, 0.85], ["J3", 167.46, 62.24, 0.85], ["J3", 167.46, 59.7, 0.85], ["J3", 167.46, 57.16, 0.85], ["J3", 167.46, 54.62, 0.85], ["J3", 167.46, 52.08, 0.85], ["J3", 167.46, 49.54, 0.85], ["J3", 167.46, 47, 0.85], ["J3", 167.46, 44.46, 0.85], ["J3", 167.46, 41.92, 0.85], ["J3", 167.46, 39.38, 0.85], ["J3", 167.46, 36.84, 0.85], ["J3", 167.46, 34.3, 0.85], ["J3", 167.46, 31.76, 0.85], ["J3", 167.46, 29.22, 0.85], ["J3", 167.46, 26.68, 0.85], ["J3", 167.46, 24.14, 0.85], ["SW8", 140.6, 120.5, 1], ["SW8", 147.1, 120.5, 1], ["SW8", 140.6, 125, 1], ["SW8", 147.1, 125, 1], ["J5", 65.639, 111.456, 0.875], ["J5", 65.639, 109.456, 0.875], ["SW7", 130.9, 120.5, 1], ["SW7", 137.4, 120.5, 1], ["SW7", 130.9, 125, 1], ["SW7", 137.4, 125, 1], ["SW1", 40.5, 30, 1], ["SW1", 34, 30, 1], ["SW1", 40.5, 25.5, 1], ["SW1", 34, 25.5, 1], ["SW6", 120.85, 120.5, 1], ["SW6", 127.35, 120.5, 1], ["SW6", 120.85, 125, 1], ["SW6", 127.35, 125, 1], ["SW13", 224.9, 42, 1], ["SW13", 218.4, 42, 1], ["SW13", 224.9, 37.5, 1], ["SW13", 218.4, 37.5, 1], ["SW16", 171.35, 54.95, 1], ["SW16", 177.85, 54.95, 1], ["SW16", 171.35, 59.45, 1], ["SW16", 177.85, 59.45, 1], ["TP2", 188.9, 124.2, 1], ["J10", 204.16, 123.12, 1.05], ["J10", 204.16, 127.3, 0.8], ["J10", 212.8, 123.12, 1.05], ["J10", 212.8, 127.3, 0.8], ["SW2", 40.5, 42, 1], ["SW2", 34, 42, 1], ["SW2", 40.5, 37.5, 1], ["SW2", 34, 37.5, 1], ["SW3", 50.5, 52, 1], ["SW3", 44, 52, 1], ["SW3", 50.5, 47.5, 1], ["SW3", 44, 47.5, 1], ["SW4", 30.5, 52, 1], ["SW4", 24, 52, 1], ["SW4", 30.5, 47.5, 1], ["SW4", 24, 47.5, 1], ["SW15", 224.9, 30, 1], ["SW15", 218.4, 30, 1], ["SW15", 224.9, 25.5, 1], ["SW15", 218.4, 25.5, 1], ["J2", 144.6, 24.14, 0.85], ["J2", 144.6, 26.68, 0.85], ["J2", 144.6, 29.22, 0.85], ["J2", 144.6, 31.76, 0.85], ["J2", 144.6, 34.3, 0.85], ["J2", 144.6, 36.84, 0.85], ["J2", 144.6, 39.38, 0.85], ["J2", 144.6, 41.92, 0.85], ["J2", 144.6, 44.46, 0.85], ["J2", 144.6, 47, 0.85], ["J2", 144.6, 49.54, 0.85], ["J2", 144.6, 52.08, 0.85], ["J2", 144.6, 54.62, 0.85], ["J2", 144.6, 57.16, 0.85], ["J2", 144.6, 59.7, 0.85], ["J2", 144.6, 62.24, 0.85], ["J2", 144.6, 64.78, 0.85], ["J2", 144.6, 67.32, 0.85], ["J2", 144.6, 69.86, 0.85], ["J2", 144.6, 72.4, 0.85], ["J2", 144.6, 74.94, 0.85], ["J2", 144.6, 77.48, 0.85], ["SW12", 214.9, 52, 1], ["SW12", 208.4, 52, 1], ["SW12", 214.9, 47.5, 1], ["SW12", 208.4, 47.5, 1]];
PCB_ASOMA_THT = 2;
