ocxpke/ocx/(list of files, cad)

Other CAD files:
carcasa/stl/capuchones/capuchon_SW6_select.stl
carcasa/stl/capuchones/capuchon_SW8_vol_mas.stl
carcasa/stl/capuchones/capuchon_SW12_C_cuadrado.stl
carcasa/stl/capuchones/capuchon_SW10_X_cruz.stl
carcasa/stl/06_pisapantalla_izq.stl
carcasa/stl/capuchones/capuchon_SW11_O_circulo.stl
carcasa/stl/capuchones/capuchon_SW2_arriba.stl
carcasa/stl/capuchones/capuchon_SW5_abajo.stl
carcasa/stl/capuchones/capuchon_SW3_derecha.stl
carcasa/stl/capuchones/capuchon_SW1_gatillo_L.stl
