ocxpke/ocx/docs/ocxPrototype.pdf

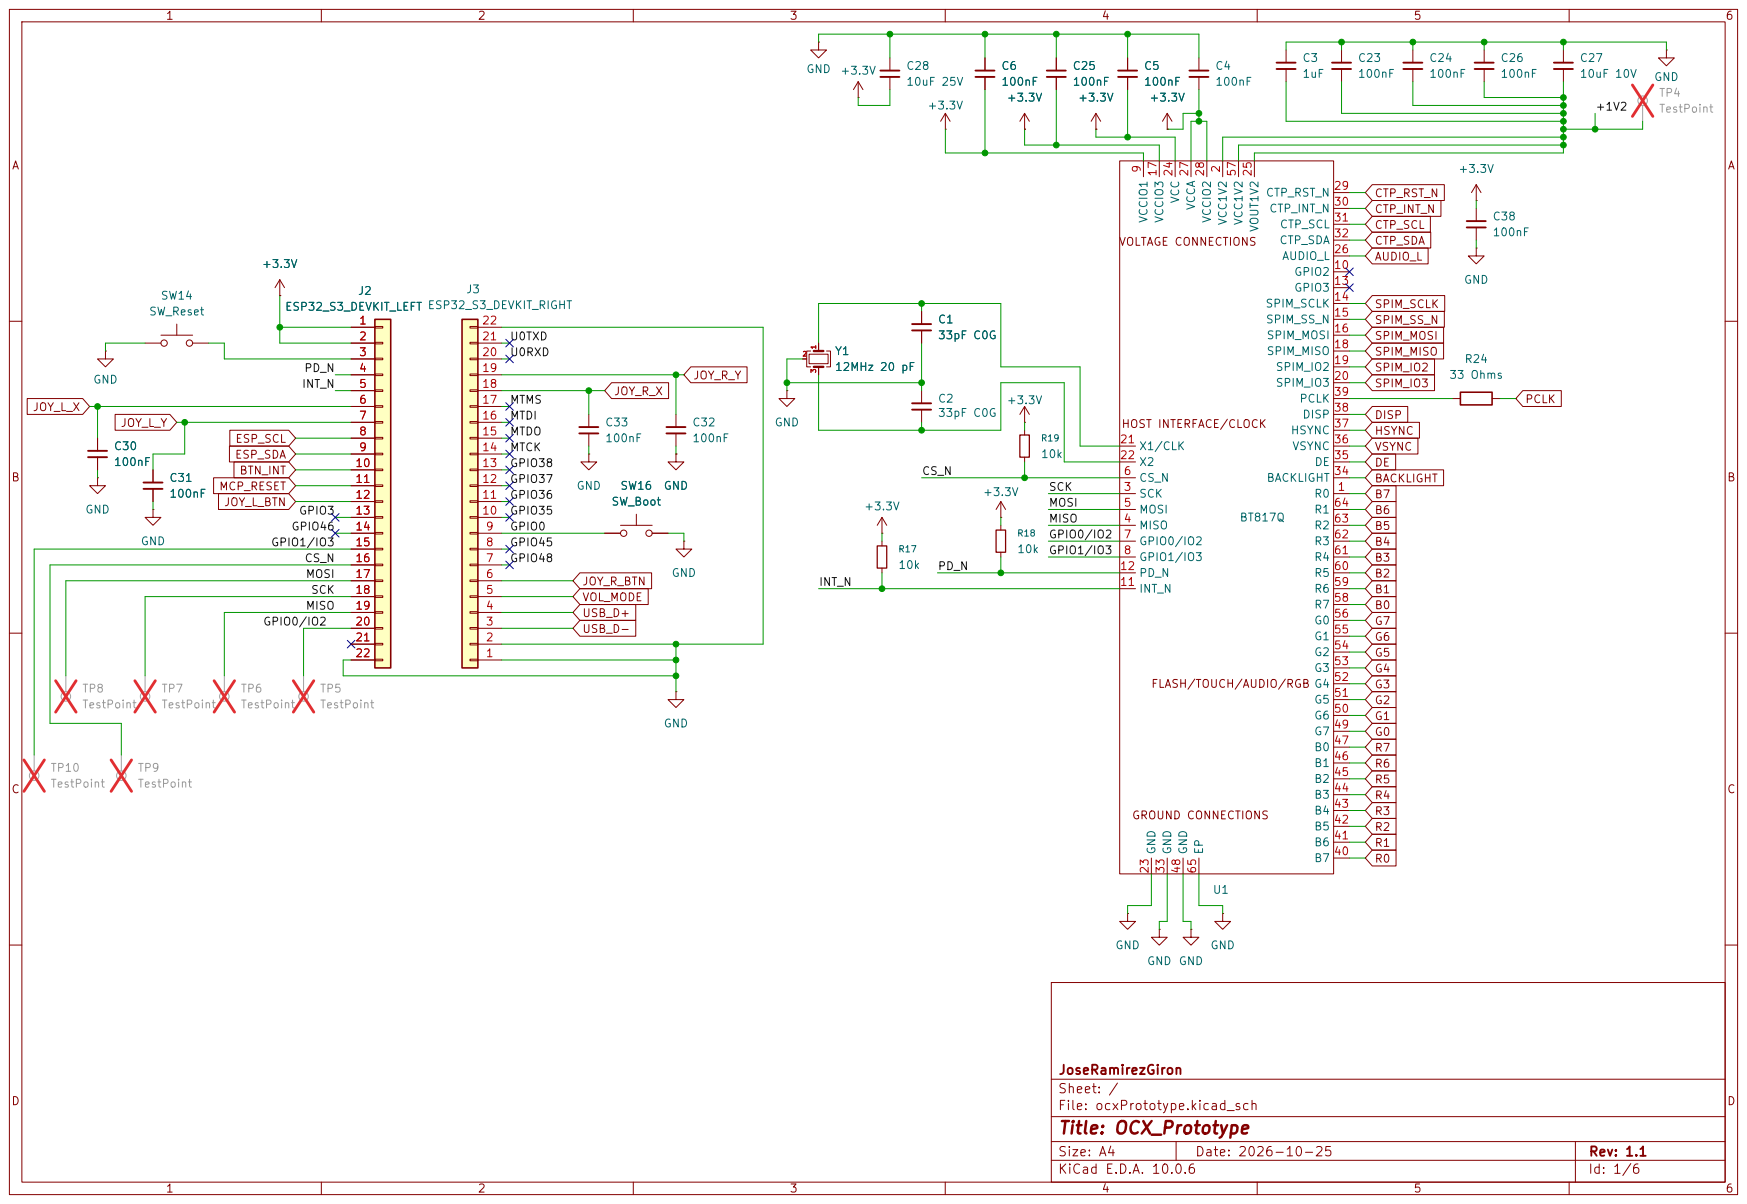
[picture p44: page 1]

VOLTAGE CONNECTIONS HOST INTERFACE/CLOCK

FLASH/TOUCH/AUDIO/RGB

Size: A4 | Rev: 1.1
KiCad E.D.A. 10.0.6 | Id: 1/6

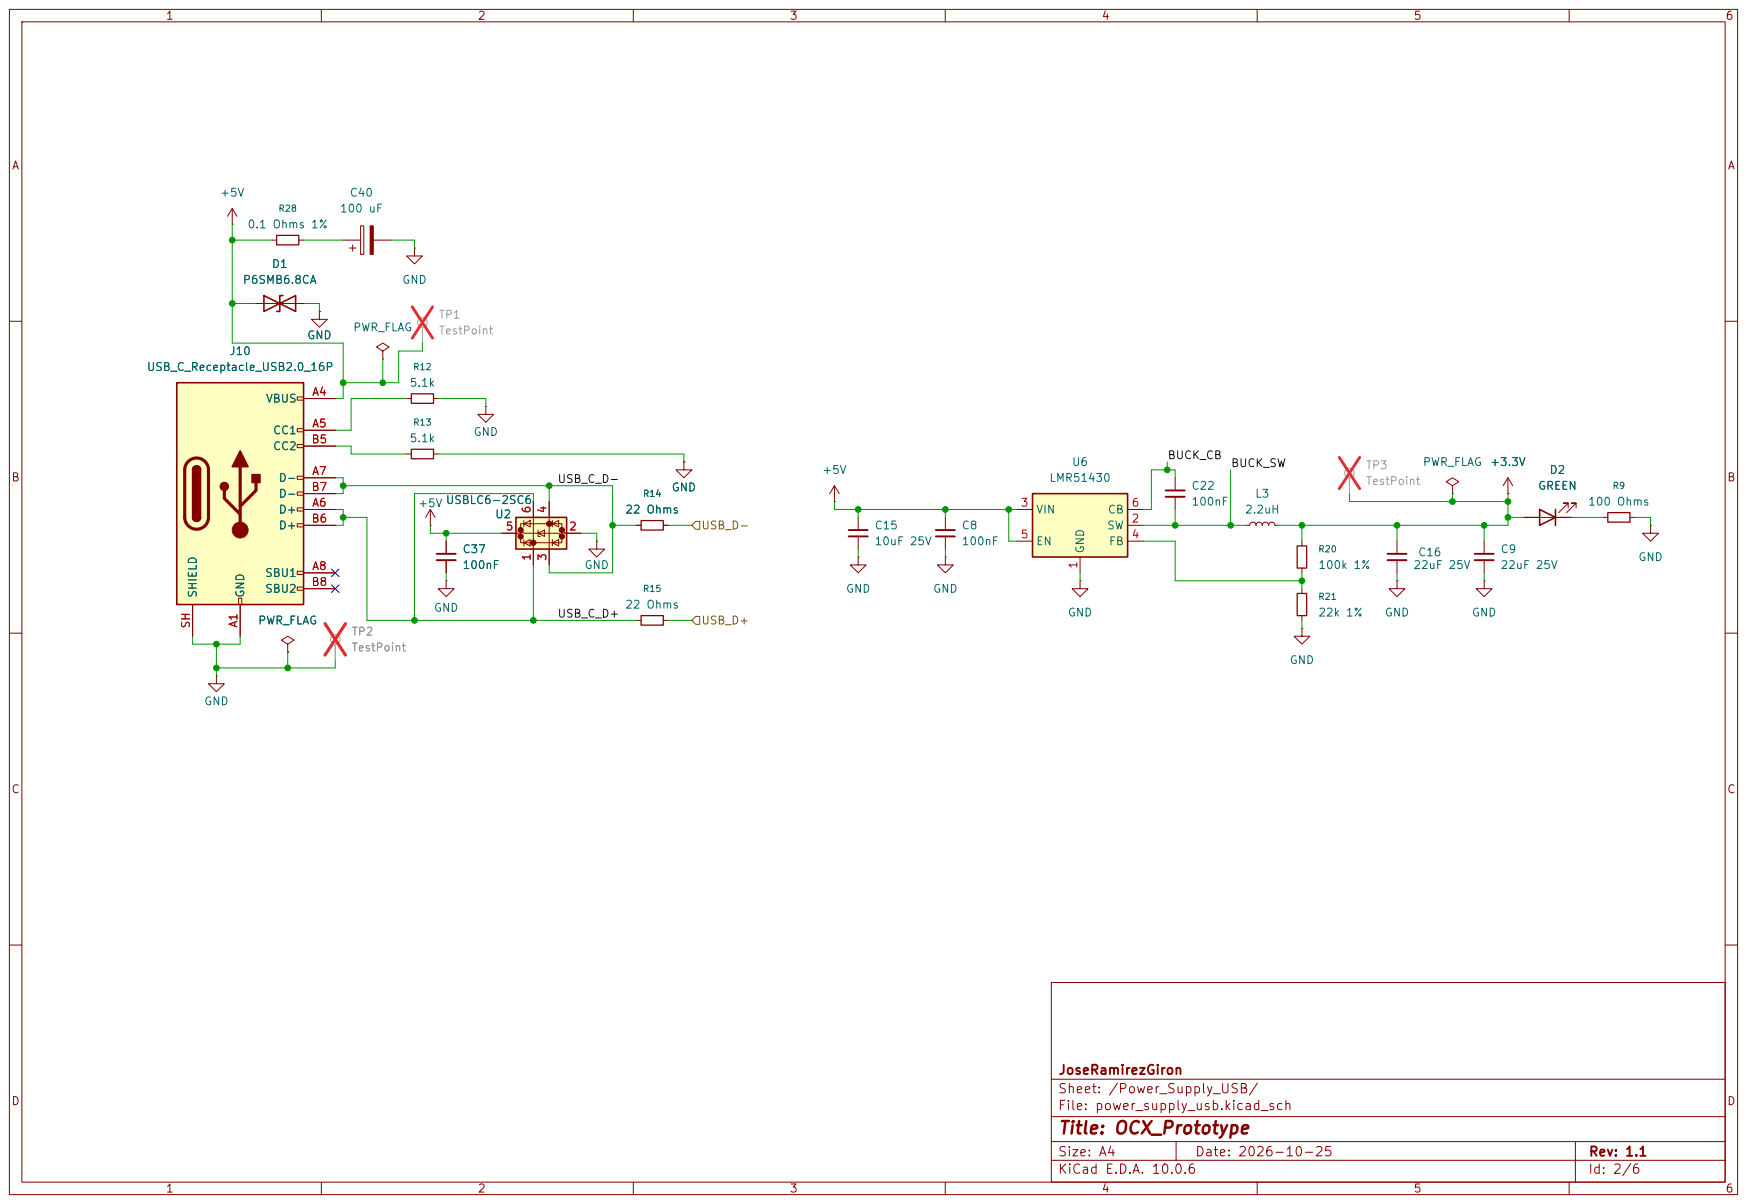
[picture p45: page 2]

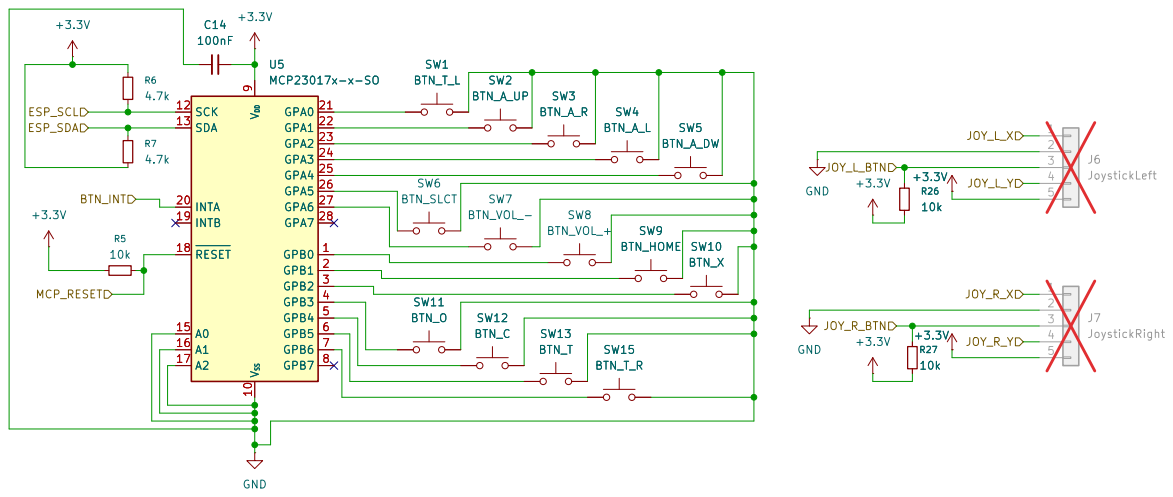
[picture p46: page 3]

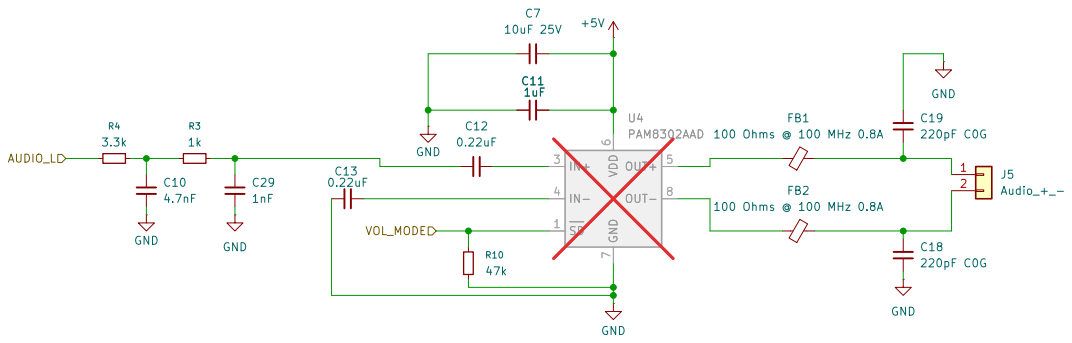
[picture p47: page 4]

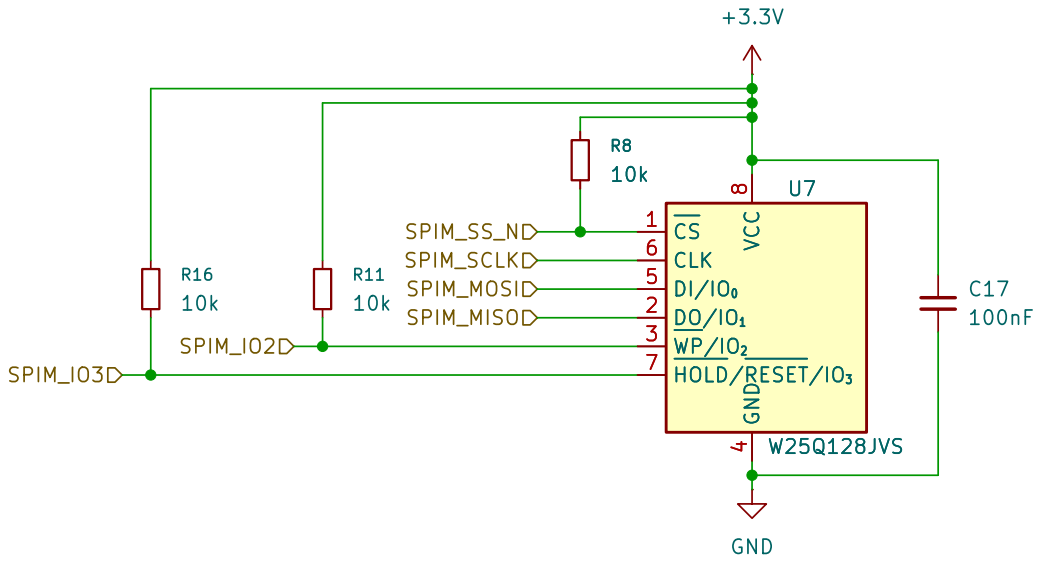
[picture p48: page 5]

4 DI/IO0 5 CLK 6 HOLD/RESET/IO3 7 VCC

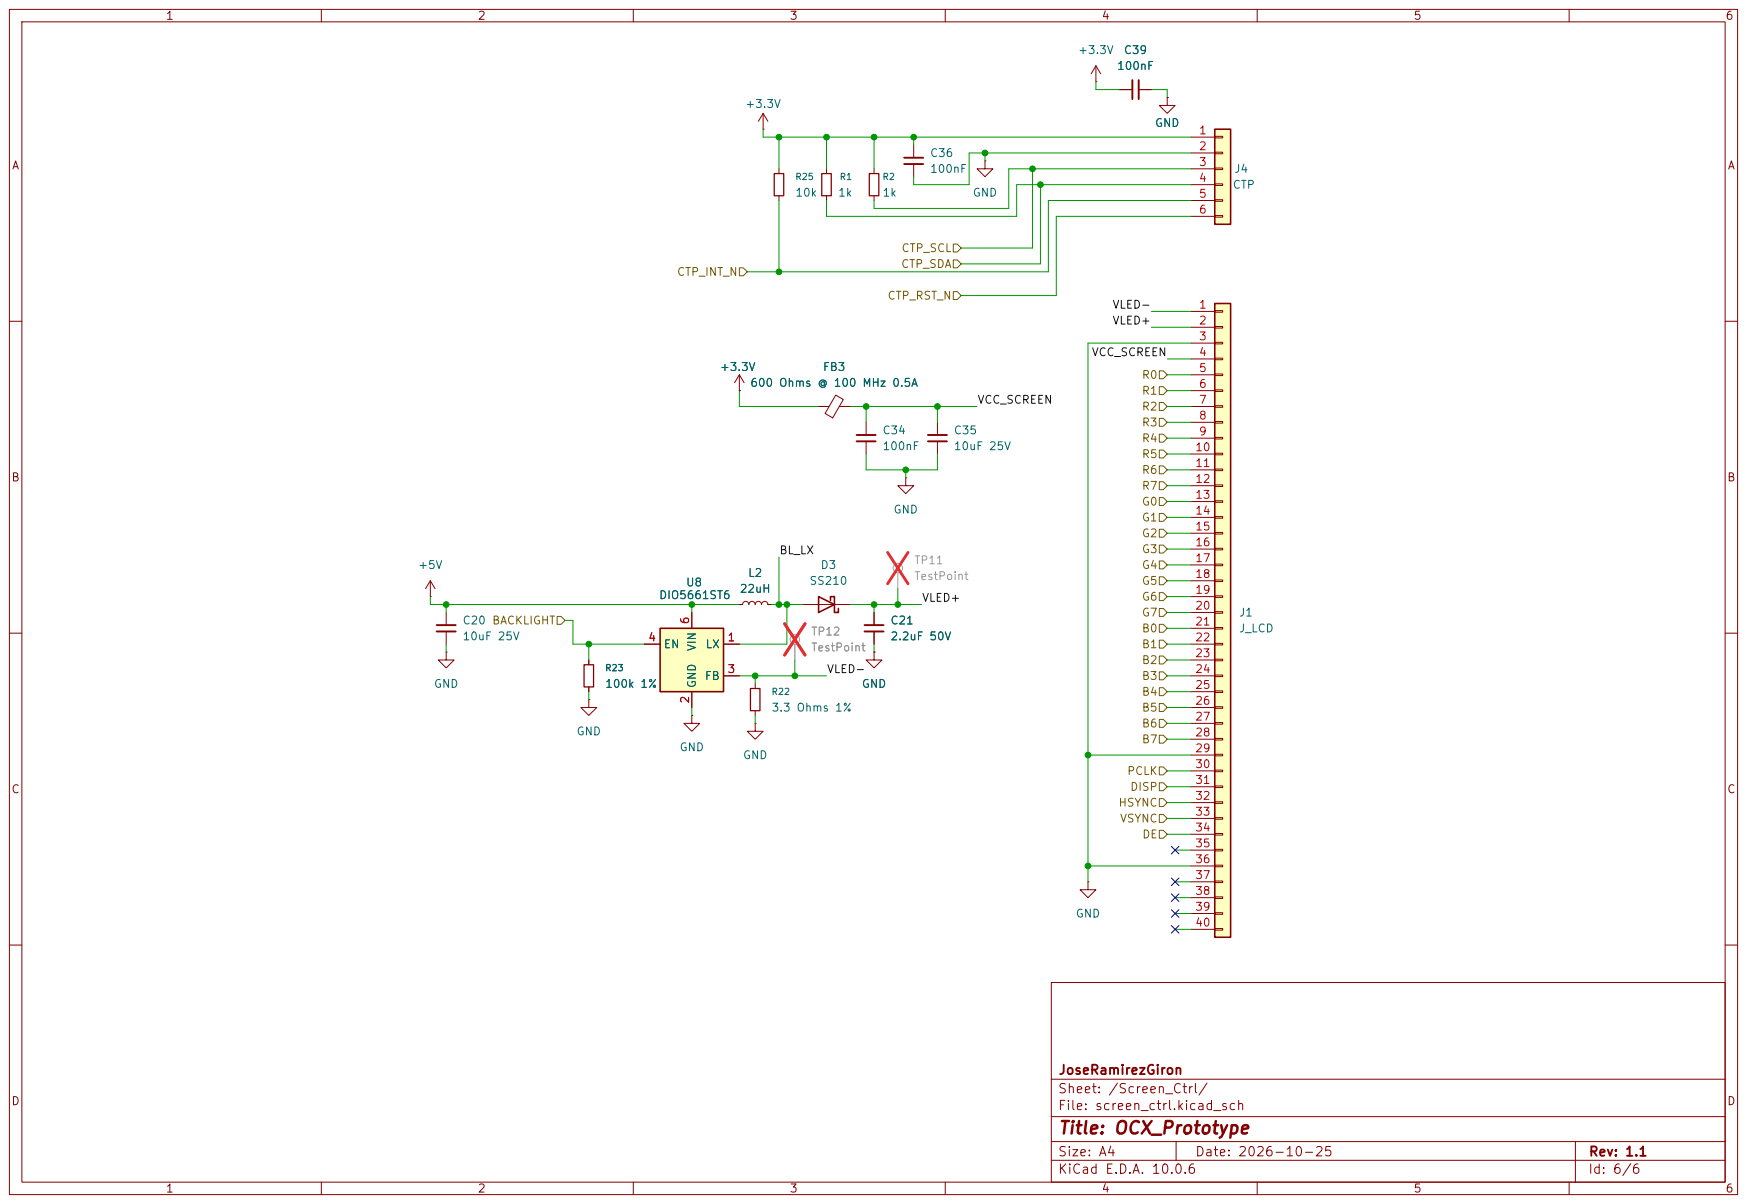
[picture p49: page 6]
