ocxpke/ocx/hardware/ocxPrototype.kicad_pcb

## KiCad design hardware/ocxPrototype.kicad_pcb (2026-11-05)

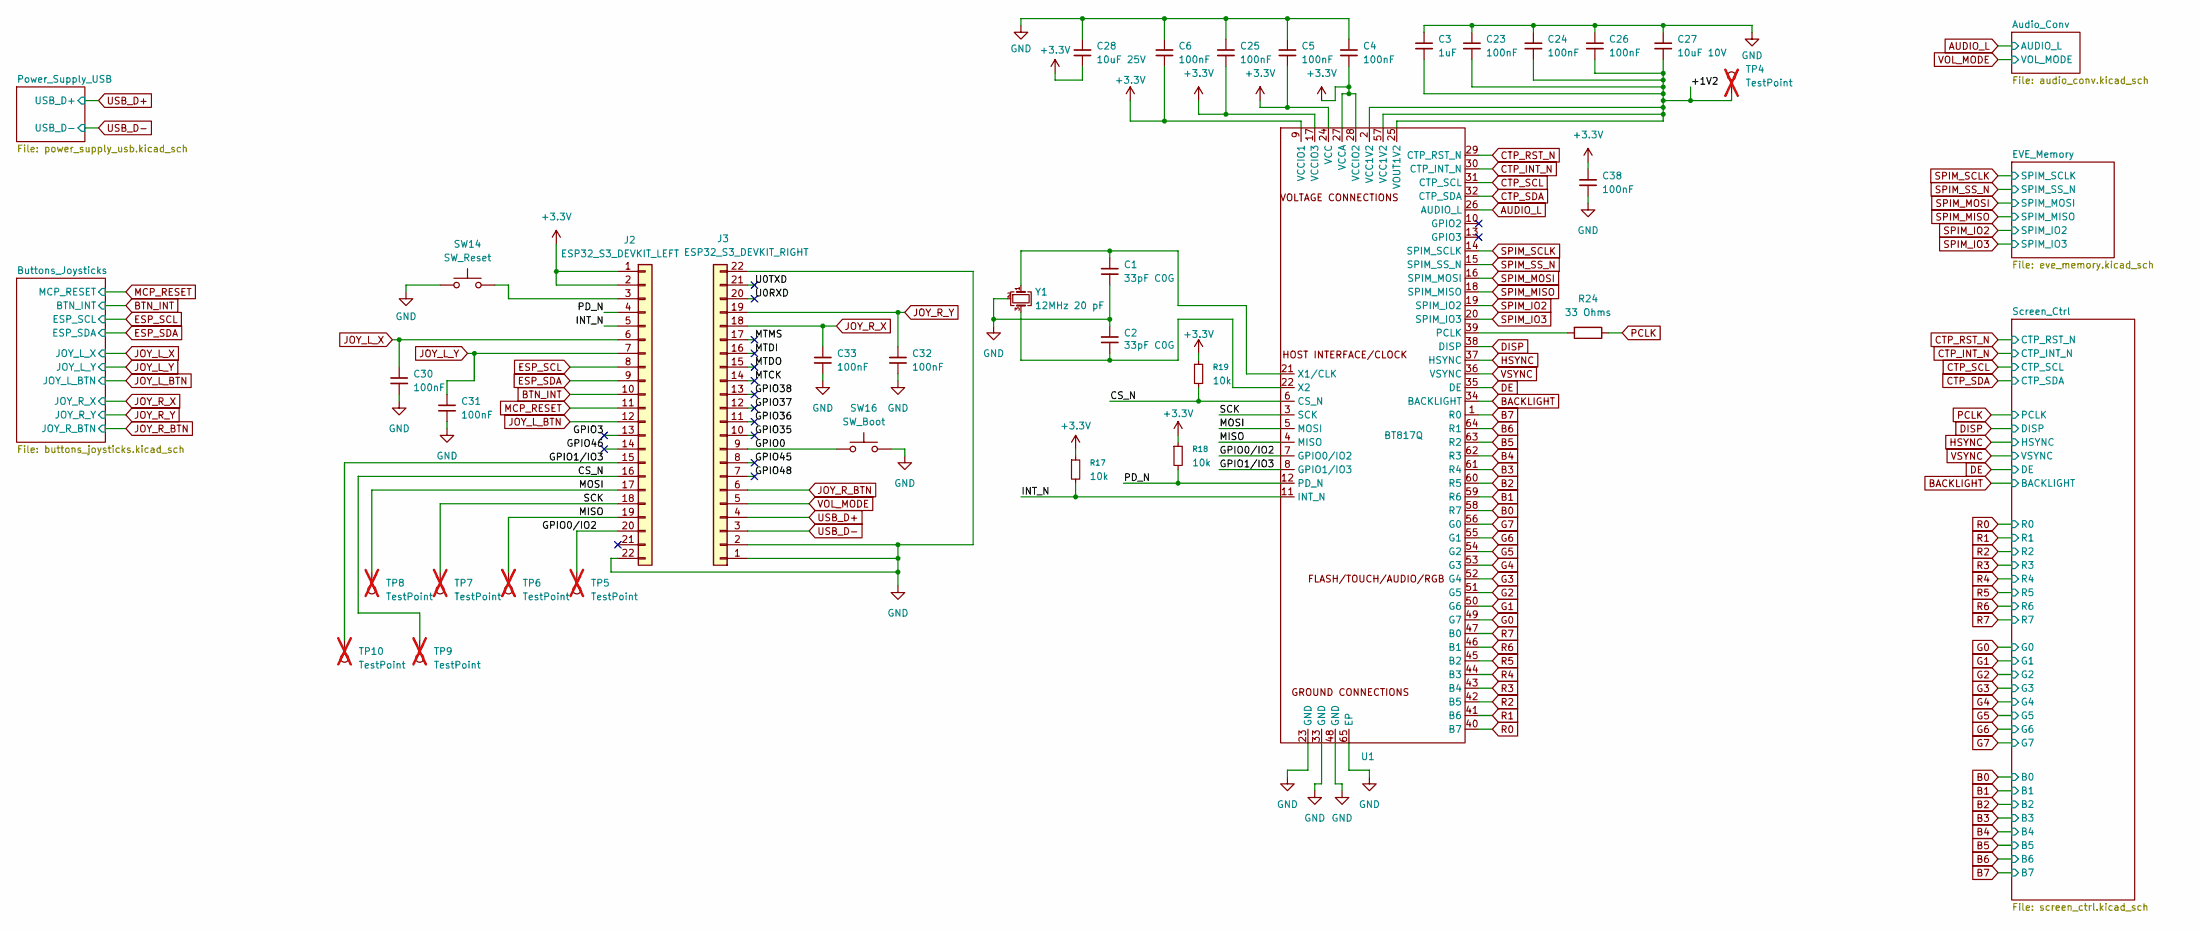
[picture p50: schematic ocxPrototype.kicad_sch, OCX_Prototype]

Parts:
C1, C2: 33pF C0G; C_0402_1005Metric; MPN 0402CG330J500NT; LCSC C1562
C3: 1uF; C_0402_1005Metric; MPN CL05A105KA5NQNC; LCSC C52923
C4, C5, C6, C23, C24, C25, C26: 100nF; C_0402_1005Metric; MPN CL05B104KO5NNNC; LCSC C1525
C27: 10uF 10V; C_0603_1608Metric; MPN CL10A106KP8NNNC; LCSC C19702
C28: 10uF 25V; C_0805_2012Metric_Pad1.18x1.45mm_HandSolder; MPN CL21A106KAYNNNE; LCSC C15850
C30, C31, C32, C33, C38: 100nF; C_0805_2012Metric_Pad1.18x1.45mm_HandSolder; MPN CC0805KRX7R9BB104; LCSC C49678
J2: ESP32_S3_DEVKIT_LEFT; PinSocket_1x22_P2.54mm_Vertical; MPN FH2.54-09-22PZD; LCSC C7500786
J3: ESP32_S3_DEVKIT_RIGHT; PinSocket_1x22_P2.54mm_Vertical; MPN FH2.54-09-22PZD; LCSC C7500786
R17, R18, R19: 10k; R_0805_2012Metric_Pad1.20x1.40mm_HandSolder; MPN 0805W8F1002T5E; LCSC C17414
R24: 33 Ohms; R_0402_1005Metric; MPN 0402WGF330JTCE; LCSC C25105
SW14: SW_Reset; SW_PUSH_6mm; MPN MLD-TS-6X6X5-J; LCSC C52750873
SW16: SW_Boot; SW_PUSH_6mm; MPN MLD-TS-6X6X5-J; LCSC C52750873
TP4: TestPoint; TestPoint_Pad_D1.5mm; not fitted
TP5, TP6, TP7, TP8, TP9, TP10: TestPoint; TestPoint_Pad_D1.0mm; not fitted
U1: BT817Q; VQFN-64-1EP_9x9mm_P0.5mm_EP5.4x5.4mm_ThermalVias; MPN BT817Q-R; LCSC C20613585
Y1: 12MHz 20 pF; Crystal_SMD_5032-4Pin_5.0x3.2mm; MPN X503212MSB4SI; LCSC C112588

Connections:
+3.3V: C4.2, C5.2, C6.2, C25.2, C28.2, C38.1, J2.1, J2.2, R17.1, R18.1, R19.1, U1.9 (VCCIO1), U1.17 (VCCIO3), U1.24 (VCC), U1.27 (VCCA), U1.28 (VCCIO2); also elsewhere on the board
/+1V2: C3.2, C23.2, C24.2, C26.2, C27.2, TP4.1 (1_1), U1.2 (VCC1V2), U1.25 (VOUT1V2), U1.57 (VCC1V2)
/CS_N: J2.16, R19.2, TP9.1 (1_1), U1.6 (CS_N)
/GPIO0: J3.9, SW16.1
/GPIO0/IO2: J2.20, TP5.1 (1_1), U1.7 (GPIO0/IO2)
/GPIO1/IO3: J2.15, TP10.1 (1_1), U1.8 (GPIO1/IO3)
/GPIO3: J2.13
/GPIO35: J3.10
/GPIO36: J3.11
/GPIO37: J3.12
/GPIO38: J3.13
/GPIO45: J3.8
/GPIO46: J2.14
/GPIO48: J3.7
/INT_N: J2.5, R17.2, U1.11 (INT_N)
/MISO: J2.19, TP6.1 (1_1), U1.4 (MISO)
/MOSI: J2.17, TP8.1 (1_1), U1.5 (MOSI)
/MTCK: J3.14
/MTDI: J3.16
/MTDO: J3.15
/MTMS: J3.17
/PD_N: J2.4, R18.2, U1.12 (PD_N)
/SCK: J2.18, TP7.1 (1_1), U1.3 (SCK)
/U0RXD: J3.20
/U0TXD: J3.21
AUDIO_L: U1.26 (AUDIO_L); also elsewhere on the board
B0: U1.58 (R7); also elsewhere on the board
B1: U1.59 (R6); also elsewhere on the board
B2: U1.60 (R5); also elsewhere on the board
B3: U1.61 (R4); also elsewhere on the board
B4: U1.62 (R3); also elsewhere on the board
B5: U1.63 (R2); also elsewhere on the board
B6: U1.64 (R1); also elsewhere on the board
B7: U1.1 (R0); also elsewhere on the board
BACKLIGHT: U1.34 (BACKLIGHT); also elsewhere on the board
BTN_INT: J2.10; also elsewhere on the board
CTP_INT_N: U1.30 (CTP_INT_N); also elsewhere on the board
CTP_RST_N: U1.29 (CTP_RST_N); also elsewhere on the board
CTP_SCL: U1.31 (CTP_SCL); also elsewhere on the board
CTP_SDA: U1.32 (CTP_SDA); also elsewhere on the board
DE: U1.35 (DE); also elsewhere on the board
DISP: U1.38 (DISP); also elsewhere on the board
ESP_SCL: J2.8; also elsewhere on the board
ESP_SDA: J2.9; also elsewhere on the board
G0: U1.49 (G7); also elsewhere on the board
G1: U1.50 (G6); also elsewhere on the board
G2: U1.51 (G5); also elsewhere on the board
G3: U1.52 (G4); also elsewhere on the board
G4: U1.53 (G3); also elsewhere on the board
G5: U1.54 (G2); also elsewhere on the board
G6: U1.55 (G1); also elsewhere on the board
G7: U1.56 (G0); also elsewhere on the board
GND: C1.1, C2.2, C3.1, C4.1, C5.1, C6.1, C23.1, C24.1, C25.1, C26.1, C27.1, C28.1, C30.2, C31.2, C32.2, C33.2, C38.2, J2.22, J3.1, J3.2, J3.22, SW14.1, SW16.2, U1.23 (GND), U1.33 (GND), U1.48 (GND), U1.65 (EP), Y1.2 (G), Y1.4 (G); also elsewhere on the board
HSYNC: U1.37 (HSYNC); also elsewhere on the board
JOY_L_BTN: J2.12; also elsewhere on the board
JOY_L_X: C30.1, J2.6; also elsewhere on the board
JOY_L_Y: C31.1, J2.7; also elsewhere on the board
JOY_R_BTN: J3.6; also elsewhere on the board
JOY_R_X: C33.1, J3.18; also elsewhere on the board
JOY_R_Y: C32.1, J3.19; also elsewhere on the board
MCP_RESET: J2.11; also elsewhere on the board
unnamed: J2.3, SW14.2
unnamed: R24.2, U1.39 (PCLK)
unnamed: C1.2, U1.21 (X1/CLK), Y1.1
unnamed: C2.1, U1.22 (X2), Y1.3
PCLK: R24.1; also elsewhere on the board
R0: U1.40 (B7); also elsewhere on the board
R1: U1.41 (B6); also elsewhere on the board
R2: U1.42 (B5); also elsewhere on the board
R3: U1.43 (B4); also elsewhere on the board
R4: U1.44 (B3); also elsewhere on the board
R5: U1.45 (B2); also elsewhere on the board
R6: U1.46 (B1); also elsewhere on the board
R7: U1.47 (B0); also elsewhere on the board
SPIM_IO2: U1.19 (SPIM_IO2); also elsewhere on the board
SPIM_IO3: U1.20 (SPIM_IO3); also elsewhere on the board
SPIM_MISO: U1.18 (SPIM_MISO); also elsewhere on the board
SPIM_MOSI: U1.16 (SPIM_MOSI); also elsewhere on the board
SPIM_SCLK: U1.14 (SPIM_SCLK); also elsewhere on the board
SPIM_SS_N: U1.15 (SPIM_SS_N); also elsewhere on the board
USB_D+: J3.4; also elsewhere on the board
USB_D-: J3.3; also elsewhere on the board
VOL_MODE: J3.5; also elsewhere on the board
VSYNC: U1.36 (VSYNC); also elsewhere on the board

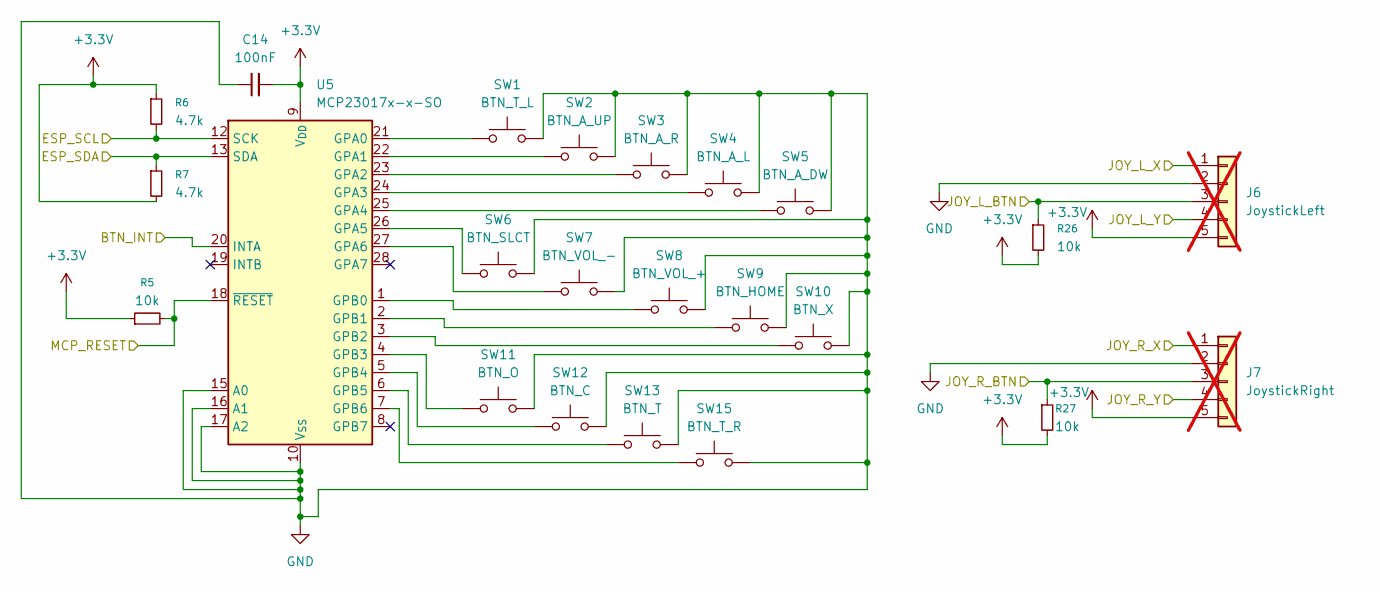
[picture p51: schematic buttons_joysticks.kicad_sch, OCX_Prototype]

Parts:
C14: 100nF; C_0805_2012Metric_Pad1.18x1.45mm_HandSolder; MPN CC0805KRX7R9BB104; LCSC C49678
J6: JoystickLeft; TE_0-1734839-5_1x05-1MP_P0.5mm_Horizontal; MPN SFV5R-4STE1HLF; not fitted
J7: JoystickRight; TE_0-1734839-5_1x05-1MP_P0.5mm_Horizontal; MPN SFV5R-4STE1HLF; not fitted
R5, R26, R27: 10k; R_0805_2012Metric_Pad1.20x1.40mm_HandSolder; MPN 0805W8F1002T5E; LCSC C17414
R6, R7: 4.7k; R_0805_2012Metric_Pad1.20x1.40mm_HandSolder; MPN 0805W8F4701T5E; LCSC C17673
SW1: BTN_T_L; SW_PUSH_6mm; MPN MLD-TS-6X6X5-J; LCSC C52750873
SW2: BTN_A_UP; SW_PUSH_6mm; MPN MLD-TS-6X6X5-J; LCSC C52750873
SW3: BTN_A_R; SW_PUSH_6mm; MPN MLD-TS-6X6X5-J; LCSC C52750873
SW4: BTN_A_L; SW_PUSH_6mm; MPN MLD-TS-6X6X5-J; LCSC C52750873
SW5: BTN_A_DW; SW_PUSH_6mm; MPN MLD-TS-6X6X5-J; LCSC C52750873
SW6: BTN_SLCT; SW_PUSH_6mm; MPN MLD-TS-6X6X5-J; LCSC C52750873
SW7: BTN_VOL_-; SW_PUSH_6mm; MPN MLD-TS-6X6X5-J; LCSC C52750873
SW8: BTN_VOL_+; SW_PUSH_6mm; MPN MLD-TS-6X6X5-J; LCSC C52750873
SW9: BTN_HOME; SW_PUSH_6mm; MPN MLD-TS-6X6X5-J; LCSC C52750873
SW10: BTN_X; SW_PUSH_6mm; MPN MLD-TS-6X6X5-J; LCSC C52750873
SW11: BTN_O; SW_PUSH_6mm; MPN MLD-TS-6X6X5-J; LCSC C52750873
SW12: BTN_C; SW_PUSH_6mm; MPN MLD-TS-6X6X5-J; LCSC C52750873
SW13: BTN_T; SW_PUSH_6mm; MPN MLD-TS-6X6X5-J; LCSC C52750873
SW15: BTN_T_R; SW_PUSH_6mm; MPN MLD-TS-6X6X5-J; LCSC C52750873
U5: MCP23017x-x-SO; SOIC-28W_7.5x17.9mm_P1.27mm; MPN MCP23017-E/SO; LCSC C47023

Connections:
+3.3V: C14.2, J6.5, J7.5, R5.1, R6.1, R7.2, R26.2, R27.2, U5.9 (V_{DD}); also elsewhere on the board
BTN_INT: U5.20 (INTA); also elsewhere on the board
ESP_SCL: R6.2, U5.12 (SCK); also elsewhere on the board
ESP_SDA: R7.1, U5.13 (SDA); also elsewhere on the board
GND: C14.1, J6.2, J7.2, SW1.2, SW2.2, SW3.2, SW4.2, SW5.2, SW6.2, SW7.2, SW8.2, SW9.2, SW10.2, SW11.2, SW12.2, SW13.2, SW15.2, U5.10 (V_{SS}), U5.15 (A0), U5.16 (A1), U5.17 (A2); also elsewhere on the board
JOY_L_BTN: J6.3, R26.1; also elsewhere on the board
JOY_L_X: J6.1; also elsewhere on the board
JOY_L_Y: J6.4; also elsewhere on the board
JOY_R_BTN: J7.3, R27.1; also elsewhere on the board
JOY_R_X: J7.1; also elsewhere on the board
JOY_R_Y: J7.4; also elsewhere on the board
MCP_RESET: R5.2, U5.18 (~RESET); also elsewhere on the board
unnamed: SW1.1, U5.21 (GPA0)
unnamed: SW2.1, U5.22 (GPA1)
unnamed: SW3.1, U5.23 (GPA2)
unnamed: SW4.1, U5.24 (GPA3)
unnamed: SW5.1, U5.25 (GPA4)
unnamed: SW6.1, U5.26 (GPA5)
unnamed: SW7.1, U5.27 (GPA6)
unnamed: SW8.1, U5.1 (GPB0)
unnamed: SW9.1, U5.2 (GPB1)
unnamed: SW10.1, U5.3 (GPB2)
unnamed: SW11.1, U5.4 (GPB3)
unnamed: SW12.1, U5.5 (GPB4)
unnamed: SW13.1, U5.6 (GPB5)
unnamed: SW15.1, U5.7 (GPB6)

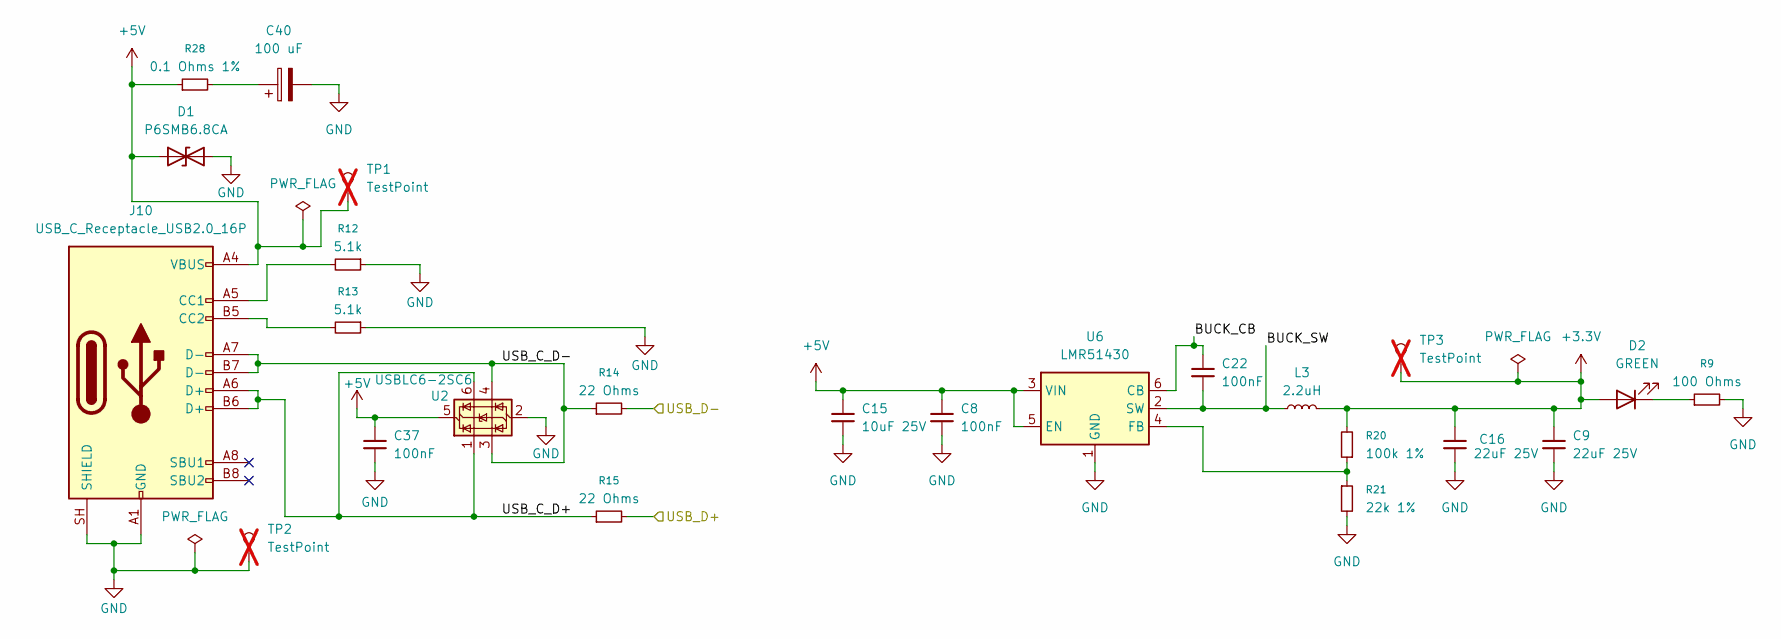
[picture p52: schematic power_supply_usb.kicad_sch, OCX_Prototype]

Parts:
C8, C22, C37: 100nF; C_0805_2012Metric_Pad1.18x1.45mm_HandSolder; MPN CC0805KRX7R9BB104; LCSC C49678
C9, C16: 22uF 25V; C_0805_2012Metric_Pad1.18x1.45mm_HandSolder; MPN CL21A226MAQNNNE; LCSC C45783
C15: 10uF 25V; C_0805_2012Metric_Pad1.18x1.45mm_HandSolder; MPN CL21A106KAYNNNE; LCSC C15850
C40: 100 uF; CP_Elec_6.3x5.8; MPN MA16V100M6X6; LCSC C46550460
D1: P6SMB6.8CA; D_SMB_Handsoldering; MPN P6SMB6.8CA/TR13; LCSC C78395
D2: GREEN; LED_0805_2012Metric_Pad1.15x1.40mm_HandSolder; MPN KT-0805G; LCSC C2297
J10: USB_C_Receptacle_USB2.0_16P; USB_C_Receptacle_HRO_TYPE-C-31-M-12; MPN TYPE-C-31-M-12; LCSC C165948
L3: 2.2uH; L_Coilcraft_XxL4020; MPN XAL4020-222MEC; LCSC C3151182
R9: 100 Ohms; R_0805_2012Metric_Pad1.20x1.40mm_HandSolder; MPN 0805W8F1000T5E; LCSC C17408
R12, R13: 5.1k; R_0805_2012Metric_Pad1.20x1.40mm_HandSolder; MPN 0805W8F5101T5E; LCSC C27834
R14, R15: 22 Ohms; R_0805_2012Metric_Pad1.20x1.40mm_HandSolder; MPN 0805W8F220JT5E; LCSC C17561
R20: 100k 1%; R_0805_2012Metric_Pad1.20x1.40mm_HandSolder; MPN 0805W8F1003T5E; LCSC C149504
R21: 22k 1%; R_0805_2012Metric_Pad1.20x1.40mm_HandSolder; MPN 0805W8F2202T5E; LCSC C17560
R28: 0.1 Ohms 1%; R_1206_3216Metric_Pad1.30x1.75mm_HandSolder; MPN 1206W4F100LT5E; LCSC C25334
TP1, TP3: TestPoint; TestPoint_Pad_D1.5mm; not fitted
TP2: TestPoint; TestPoint_Keystone_5000-5004_Miniature; not fitted
U2: USBLC6-2SC6; SOT-23-6; MPN USBLC6-2SC6; LCSC C7519
U6: LMR51430; SOT-23-6; MPN LMR51430YDDCR; LCSC C5210749

Connections:
+3.3V: C9.1, C16.1, D2.2 (A), L3.2, R20.2, TP3.1 (1_1); also elsewhere on the board
+5V: C8.1, C15.1, C37.1, D1.1 (A1), J10.A4 (VBUS), J10.A9 (VBUS), J10.B4 (VBUS), J10.B9 (VBUS), R28.1, TP1.1 (1_1), U2.5 (VBUS), U6.3 (VIN), U6.5 (EN); also elsewhere on the board
/Power_Supply_USB/BUCK_CB: C22.1, U6.6 (CB)
/Power_Supply_USB/BUCK_SW: C22.2, L3.1, U6.2 (SW)
/Power_Supply_USB/USB_C_D+: J10.A6 (D+), J10.B6 (D+), R15.1, U2.1 (I/O1), U2.6 (I/O1)
/Power_Supply_USB/USB_C_D-: J10.A7 (D-), J10.B7 (D-), R14.1, U2.3 (I/O2), U2.4 (I/O2)
GND: C8.2, C9.2, C15.2, C16.2, C37.2, C40.2, D1.2 (A2), J10.A1 (GND), J10.A12 (GND), J10.B1 (GND), J10.B12 (GND), J10.SH (SHIELD), R9.2, R12.1, R13.1, R21.2, TP2.1 (1_1), U2.2 (GND), U6.1 (GND); also elsewhere on the board
unnamed: C40.1, R28.2
unnamed: D2.1 (K), R9.1
unnamed: J10.A5 (CC1), R12.2
unnamed: J10.B5 (CC2), R13.2
unnamed: R20.1, R21.1, U6.4 (FB)
USB_D+: R15.2; also elsewhere on the board
USB_D-: R14.2; also elsewhere on the board

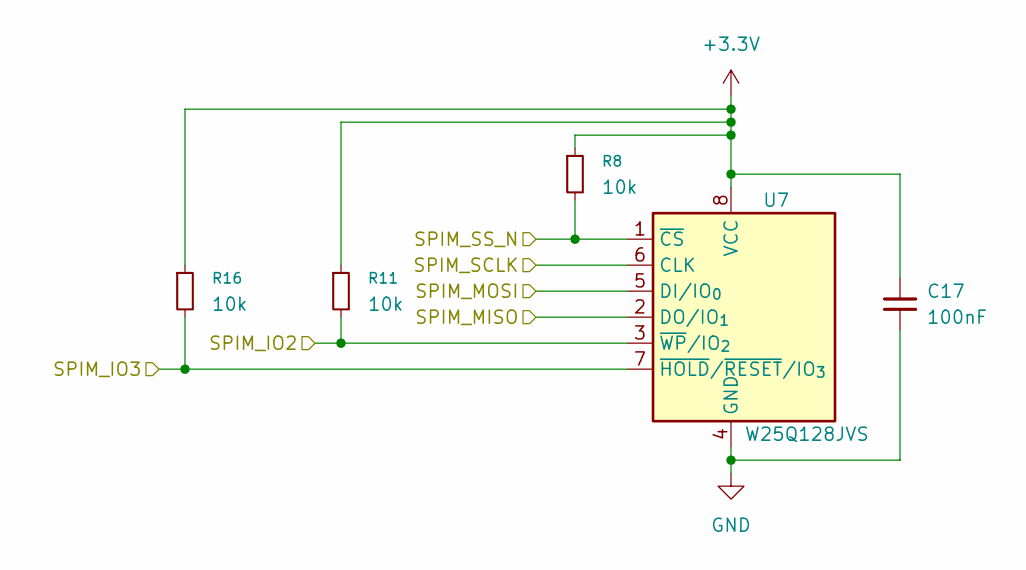
[picture p53: schematic eve_memory.kicad_sch, OCX_Prototype]

Parts:
C17: 100nF; C_0402_1005Metric; MPN CL05B104KO5NNNC; LCSC C1525
R8, R11, R16: 10k; R_0805_2012Metric_Pad1.20x1.40mm_HandSolder; MPN 0805W8F1002T5E; LCSC C17414
U7: W25Q128JVS; SOIC-8_5.3x5.3mm_P1.27mm; MPN W25Q128JVSIQ; LCSC C97521

Connections:
+3.3V: C17.1, R8.1, R11.1, R16.1, U7.8 (VCC); also elsewhere on the board
GND: C17.2, U7.4 (GND); also elsewhere on the board
SPIM_IO2: R11.2, U7.3 (~WP/IO_{2}); also elsewhere on the board
SPIM_IO3: R16.2, U7.7 (~HOLD/~RESET/IO_{3}); also elsewhere on the board
SPIM_MISO: U7.2 (DO/IO_{1}); also elsewhere on the board
SPIM_MOSI: U7.5 (DI/IO_{0}); also elsewhere on the board
SPIM_SCLK: U7.6 (CLK); also elsewhere on the board
SPIM_SS_N: R8.2, U7.1 (~CS); also elsewhere on the board

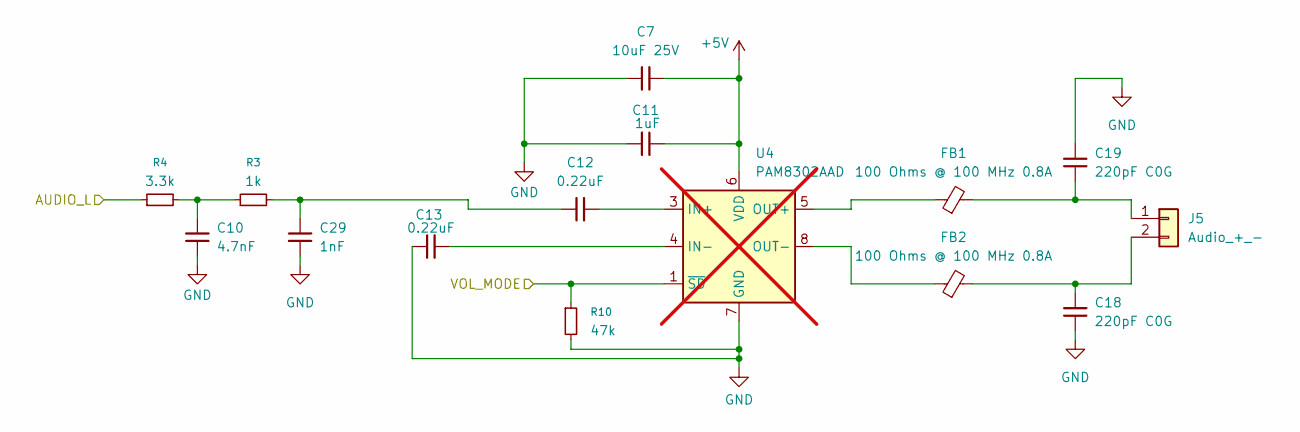
[picture p54: schematic audio_conv.kicad_sch, OCX_Prototype]

Parts:
C7: 10uF 25V; C_0805_2012Metric_Pad1.18x1.45mm_HandSolder; MPN CL21A106KAYNNNE; LCSC C15850
C10: 4.7nF; C_0805_2012Metric_Pad1.18x1.45mm_HandSolder; MPN CL21B472KBANNNC; LCSC C50131
C11: 1uF; C_0805_2012Metric_Pad1.18x1.45mm_HandSolder; MPN CL21B105KBFNNNE; LCSC C28323
C12, C13: 0.22uF; C_0805_2012Metric_Pad1.18x1.45mm_HandSolder; MPN CL21B224KBFNNNE; LCSC C5378
C18, C19: 220pF C0G; C_0805_2012Metric_Pad1.18x1.45mm_HandSolder; MPN CC0805JRNPO9BN221; LCSC C107112
C29: 1nF; C_0805_2012Metric_Pad1.18x1.45mm_HandSolder; MPN CL21B102KBCNNNC; LCSC C46653
FB1, FB2: 100 Ohms @ 100 MHz 0.8A; L_0805_2012Metric_Pad1.05x1.20mm_HandSolder; MPN GZ2012D101TF; LCSC C1015
J5: Audio_+_-; JST_PH_B2B-PH-K_1x02_P2.00mm_Vertical; MPN B2B-PH-K-S(LF)(SN); LCSC C131337
R3: 1k; R_0805_2012Metric_Pad1.20x1.40mm_HandSolder; MPN 0805W8F1001T5E; LCSC C17513
R4: 3.3k; R_0805_2012Metric_Pad1.20x1.40mm_HandSolder; MPN 0805W8F3301T5E; LCSC C26010
R10: 47k; R_0805_2012Metric_Pad1.20x1.40mm_HandSolder; MPN 0805W8F4702T5E; LCSC C17713
U4: PAM8302AAD; SOIC-8_3.9x4.9mm_P1.27mm; MPN PAM8302AADCR; not fitted

Connections:
+5V: C7.2, C11.2, U4.6 (VDD); also elsewhere on the board
AUDIO_L: R4.1; also elsewhere on the board
GND: C7.1, C10.1, C11.1, C13.1, C18.2, C19.1, C29.2, R10.2, U4.7 (GND); also elsewhere on the board
unnamed: C10.2, R3.1, R4.2
unnamed: C12.1, C29.1, R3.2
unnamed: C19.2, FB1.2, J5.1
unnamed: C18.1, FB2.2, J5.2
unnamed: C12.2, U4.3 (IN+)
unnamed: C13.2, U4.4 (IN-)
unnamed: FB1.1, U4.5 (OUT+)
unnamed: FB2.1, U4.8 (OUT-)
VOL_MODE: R10.1, U4.1 (~SD); also elsewhere on the board

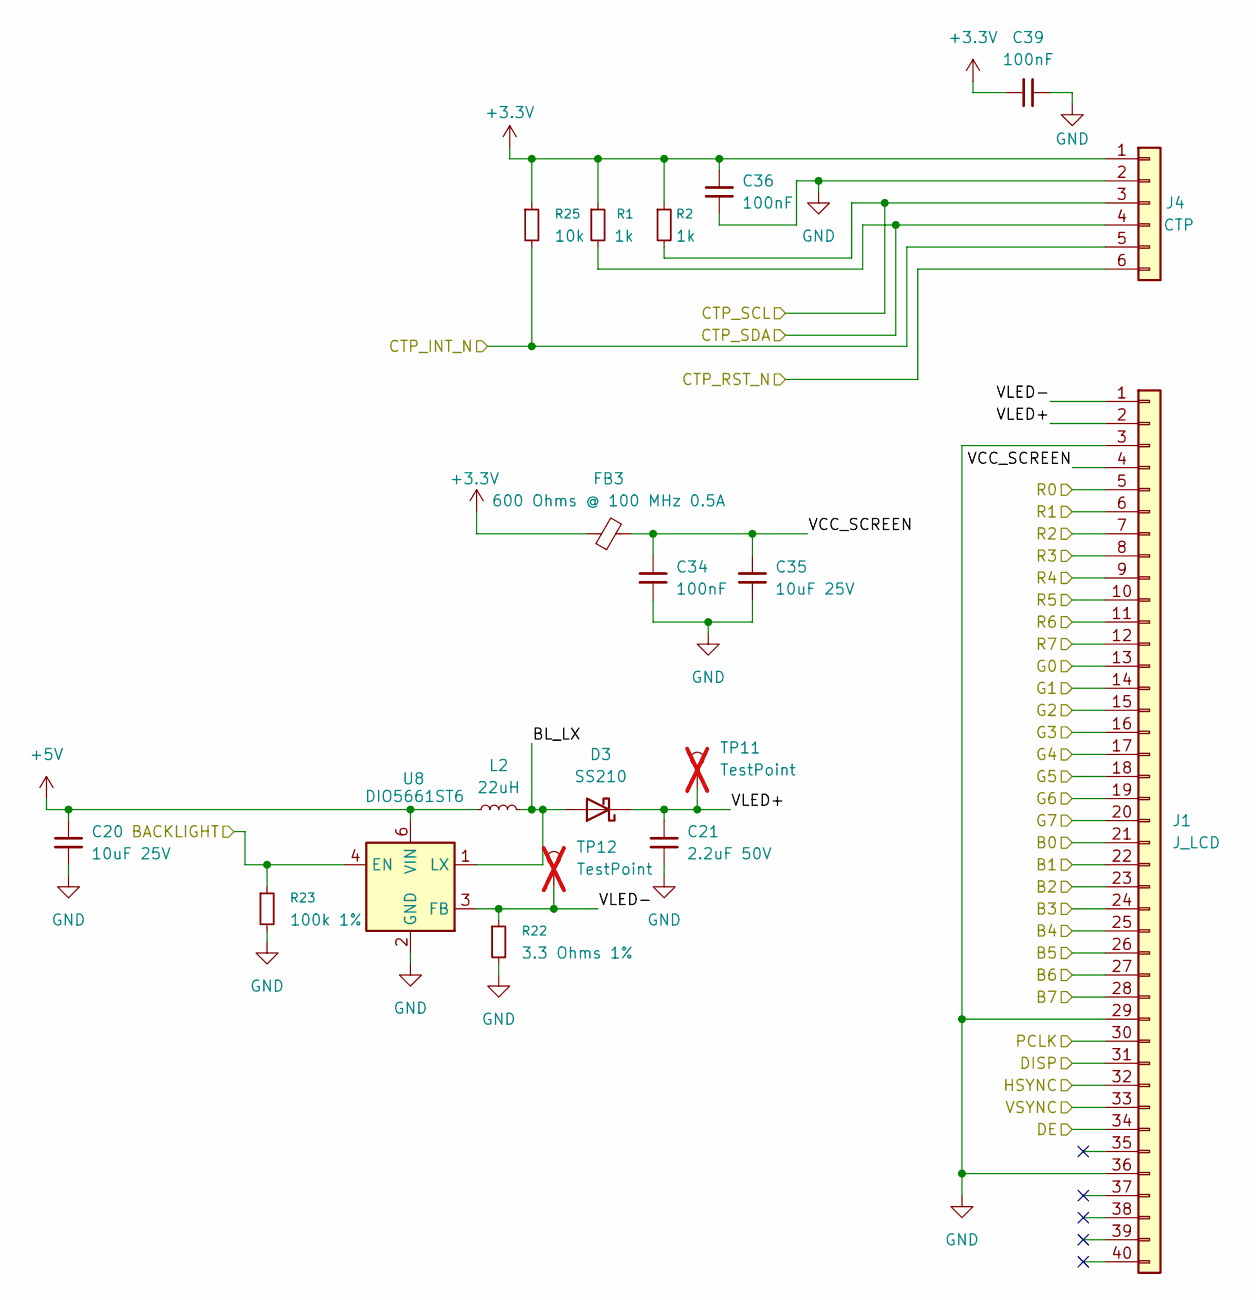
[picture p55: schematic screen_ctrl.kicad_sch, OCX_Prototype]

Parts:
C20, C35: 10uF 25V; C_0805_2012Metric_Pad1.18x1.45mm_HandSolder; MPN CL21A106KAYNNNE; LCSC C15850
C21: 2.2uF 50V; C_1206_3216Metric_Pad1.33x1.80mm_HandSolder; MPN CL31B225KBHNNNE; LCSC C50254
C34, C36, C39: 100nF; C_0805_2012Metric_Pad1.18x1.45mm_HandSolder; MPN CC0805KRX7R9BB104; LCSC C49678
D3: SS210; D_SMA_Handsoldering; MPN SS210; LCSC C14996
FB3: 600 Ohms @ 100 MHz 0.5A; L_0805_2012Metric_Pad1.05x1.20mm_HandSolder; MPN GZ2012D601TF; LCSC C1017
J1: J_LCD; Omron_XF2M-4015-1A_1x40-1MP_P0.5mm_Horizontal; MPN XF2M-4015-1A; LCSC C225713
J4: CTP; TE_84953-6_1x06-1MP_P1.0mm_Horizontal; MPN 84953-6; LCSC C408826
L2: 22uH; L_Sunlord_SWPA4030S; MPN FNR4030S220MT; LCSC C167883
R1, R2: 1k; R_0805_2012Metric_Pad1.20x1.40mm_HandSolder; MPN 0805W8F1001T5E; LCSC C17513
R22: 3.3 Ohms 1%; R_0805_2012Metric_Pad1.20x1.40mm_HandSolder; MPN FRC0805F3R30TS; LCSC C2907250
R23: 100k 1%; R_0805_2012Metric_Pad1.20x1.40mm_HandSolder; MPN 0805W8F1003T5E; LCSC C149504
R25: 10k; R_0805_2012Metric_Pad1.20x1.40mm_HandSolder; MPN 0805W8F1002T5E; LCSC C17414
TP11, TP12: TestPoint; TestPoint_Pad_D1.5mm; not fitted
U8: DIO5661ST6; SOT-23-6; MPN DIO5661ST6; LCSC C324576

Connections:
+3.3V: C36.1, C39.1, FB3.1, J4.1, R1.1, R2.1, R25.1; also elsewhere on the board
+5V: C20.1, L2.1, U8.6 (VIN); also elsewhere on the board
/Screen_Ctrl/BL_LX: D3.2 (A), L2.2, U8.1 (LX)
/Screen_Ctrl/VCC_SCREEN: C34.1, C35.1, FB3.2, J1.4
/Screen_Ctrl/VLED+: C21.1, D3.1 (K), J1.2, TP11.1 (1_1)
/Screen_Ctrl/VLED-: J1.1, R22.1, TP12.1 (1_1), U8.3 (FB)
B0: J1.21; also elsewhere on the board
B1: J1.22; also elsewhere on the board
B2: J1.23; also elsewhere on the board
B3: J1.24; also elsewhere on the board
B4: J1.25; also elsewhere on the board
B5: J1.26; also elsewhere on the board
B6: J1.27; also elsewhere on the board
B7: J1.28; also elsewhere on the board
BACKLIGHT: R23.1, U8.4 (EN); also elsewhere on the board
CTP_INT_N: J4.5, R25.2; also elsewhere on the board
CTP_RST_N: J4.6; also elsewhere on the board
CTP_SCL: J4.3, R2.2; also elsewhere on the board
CTP_SDA: J4.4, R1.2; also elsewhere on the board
DE: J1.34; also elsewhere on the board
DISP: J1.31; also elsewhere on the board
G0: J1.13; also elsewhere on the board
G1: J1.14; also elsewhere on the board
G2: J1.15; also elsewhere on the board
G3: J1.16; also elsewhere on the board
G4: J1.17; also elsewhere on the board
G5: J1.18; also elsewhere on the board
G6: J1.19; also elsewhere on the board
G7: J1.20; also elsewhere on the board
GND: C20.2, C21.2, C34.2, C35.2, C36.2, C39.2, J1.3, J1.29, J1.36, J4.2, R22.2, R23.2, U8.2 (GND); also elsewhere on the board
HSYNC: J1.32; also elsewhere on the board
PCLK: J1.30; also elsewhere on the board
R0: J1.5; also elsewhere on the board
R1: J1.6; also elsewhere on the board
R2: J1.7; also elsewhere on the board
R3: J1.8; also elsewhere on the board
R4: J1.9; also elsewhere on the board
R5: J1.10; also elsewhere on the board
R6: J1.11; also elsewhere on the board
R7: J1.12; also elsewhere on the board
VSYNC: J1.33; also elsewhere on the board

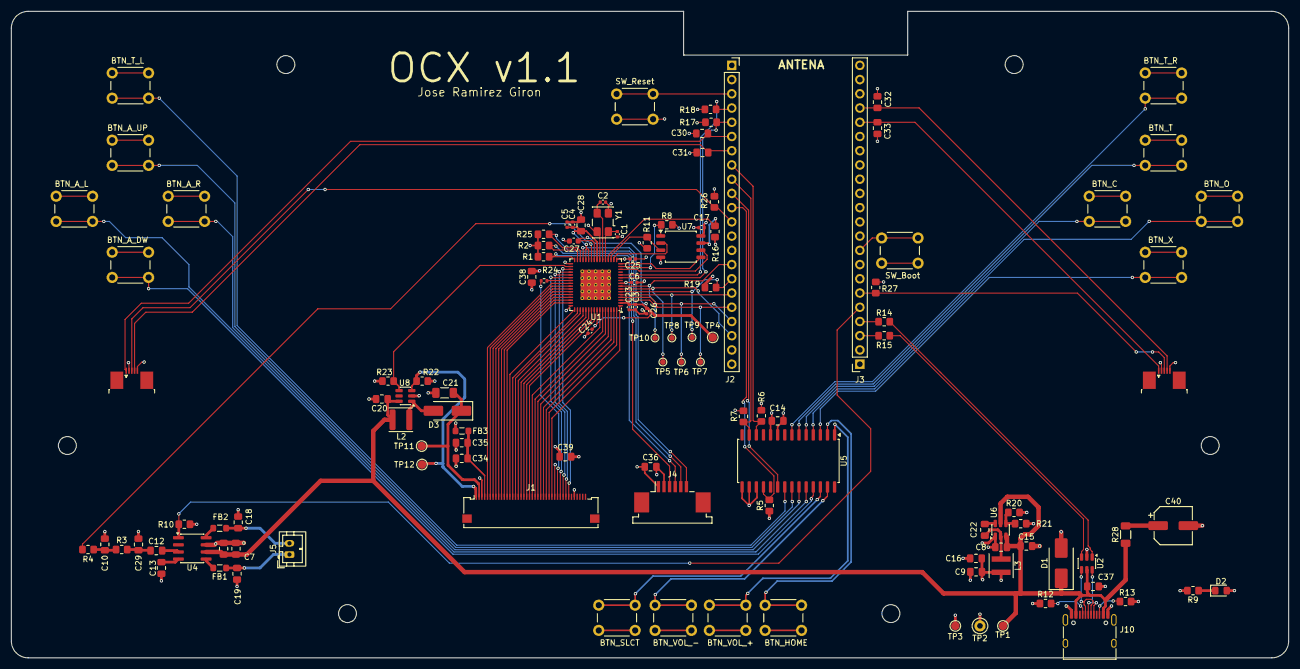
[picture p56: board ocxPrototype.kicad_pcb from above]

Board: 4 copper layers, 228.0 x 115.4 mm, 120 parts (0 on the bottom side), 106 nets.
