ocxpke/ocx/carcasa/perfil/finder_pla_0.2.ini

# Perfil APROXIMADO de una Flashforge Finder (140x140x140, sin cama caliente) para PrusaSlicer.
# Solo se usa para estimar tiempo y filamento (scripts/estimar_impresion.py).
# Para imprimir de verdad usa FlashPrint con los ajustes del MANUAL-MONTAJE.md.
bed_shape = 0x0,140x0,140x140,0x140
max_print_height = 140
nozzle_diameter = 0.4
filament_diameter = 1.75
filament_density = 1.24
filament_cost = 20
temperature = 205
first_layer_temperature = 210
bed_temperature = 0
first_layer_bed_temperature = 0
layer_height = 0.2
first_layer_height = 0.3
perimeters = 3
top_solid_layers = 5
bottom_solid_layers = 4
fill_density = 20%
fill_pattern = grid
skirts = 1
skirt_distance = 3
brim_width = 0
support_material = 0
perimeter_speed = 40
external_perimeter_speed = 30
infill_speed = 60
solid_infill_speed = 40
top_solid_infill_speed = 30
bridge_speed = 25
gap_fill_speed = 25
small_perimeter_speed = 20
travel_speed = 100
first_layer_speed = 20
machine_max_acceleration_extruding = 1000
machine_max_acceleration_retracting = 1000
machine_max_acceleration_travel = 1500
machine_max_acceleration_x = 1000
machine_max_acceleration_y = 1000
machine_max_feedrate_x = 150
machine_max_feedrate_y = 150
machine_max_feedrate_z = 10
machine_max_jerk_x = 10
machine_max_jerk_y = 10
gcode_flavor = marlin2
retract_length = 1.3
retract_speed = 30
cooling = 1
fan_always_on = 1
min_fan_speed = 100
max_fan_speed = 100
disable_fan_first_layers = 3
