ocxpke/ocx/(commit log)

2026-10-26 Initial commit: complete KiCad project, schematics and routing
    [audio_conv.kicad_sch, buttons_joysticks.kicad_sch, eve_memory.kicad_sch, ocxPrototype.kicad_pcb, ocxPrototype.kicad_sch, power_supply_usb.kicad_sch, screen_ctrl.kicad_sch]
2026-10-31 README update + schematic PDF
    [ocxPrototype.kicad_pcb, ocxPrototype.kicad_sch, power_supply_usb.kicad_sch, screen_ctrl.kicad_sch]
2026-11-01 Fab v1.0: add LCSC/MPN fields, TVS diode for VBUS transient protection, 33 pF crystal caps, wider antenna cutout
    [audio_conv.kicad_sch, buttons_joysticks.kicad_sch, eve_memory.kicad_sch, ocxPrototype.kicad_pcb, ocxPrototype.kicad_sch, power_supply_usb.kicad_sch, screen_ctrl.kicad_sch]
2026-11-03 Fab v1.1: Fix joystick pinout, add VBUS cap and joysticks buttons pull-ups
    [audio_conv.kicad_sch, buttons_joysticks.kicad_sch, eve_memory.kicad_sch, ocxPrototype.kicad_pcb, ocxPrototype.kicad_sch, power_supply_usb.kicad_sch, screen_ctrl.kicad_sch]
2026-11-05 Minor fixes: add R28 damping, C29 1 nF, U6 GND via,and move TPs
    [audio_conv.kicad_sch, ocxPrototype.kicad_pcb, power_supply_usb.kicad_sch]
2026-11-05 Bring carcasa/ from claude/confident-franklin-9exgmd
    Unchanged copy of the enclosure folder, taken with
    git checkout origin/claude/confident-franklin-9exgmd -- carcasa/
    Claude-Session: https://claude.ai/code/session_01Kzy4FNY8Mp3h5CzYX22dUN
    [00_probeta_ajustes.stl, 01_frontal_izquierda.stl, 02_frontal_central.stl, 03_frontal_derecha.stl, 04_trasera_izquierda.stl, 05_trasera_derecha.stl, 06_pisapantalla_izq.stl, 07_pisapantalla_der.stl]
2026-11-05 carcasa: update to current board, rework joystick cable, add TFT FPC extender
    - Regenerate scad/pcb_data.scad from hardware/ on main (C40, D2, R9 and the
    test points moved, new R28). The LED light pipe follows D2.
    - Joysticks: each module now sits south of J6/J7, rotated 180 degrees, axis
    aligned with the connector at (37.5;105.7) and (221.8;105.7). The cable
    leaves the north edge and drops to the connector with an S, never folded
    180 degrees. New cable parameters (joy_fpc_largo, default 24 mm) and cable
    keep-out zone. comprobar.py solves the cable as a clamped elastic strip:
    24 mm gives a 4.2 mm minimum bend radius; lengths 21.0-32.4 mm fit.
    Speaker moved to (40;80.5); LED tub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
    [01_frontal_izquierda.stl, 03_frontal_derecha.stl, carcasa.scad, componentes.scad, parametros.scad, pcb_data.scad, renders.scad]
